mcleancraig/presence-sensor-nrf/enclosure/out/sections/aura_c_center_xz.png

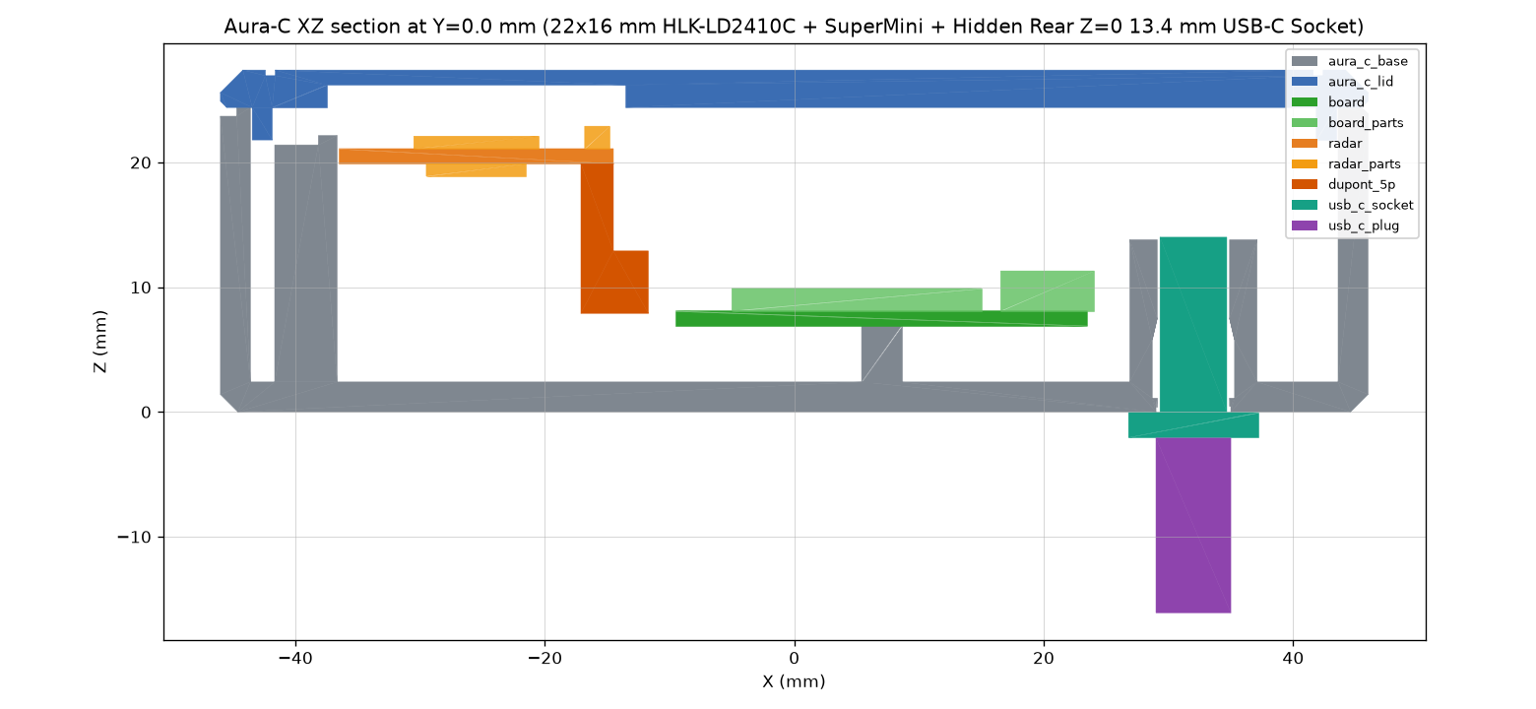
enclosure/out/sections/aura_c_center_xz.png
