mcleancraig/presence-sensor-nrf/enclosure/out/sections/aura_c_front_xy.png

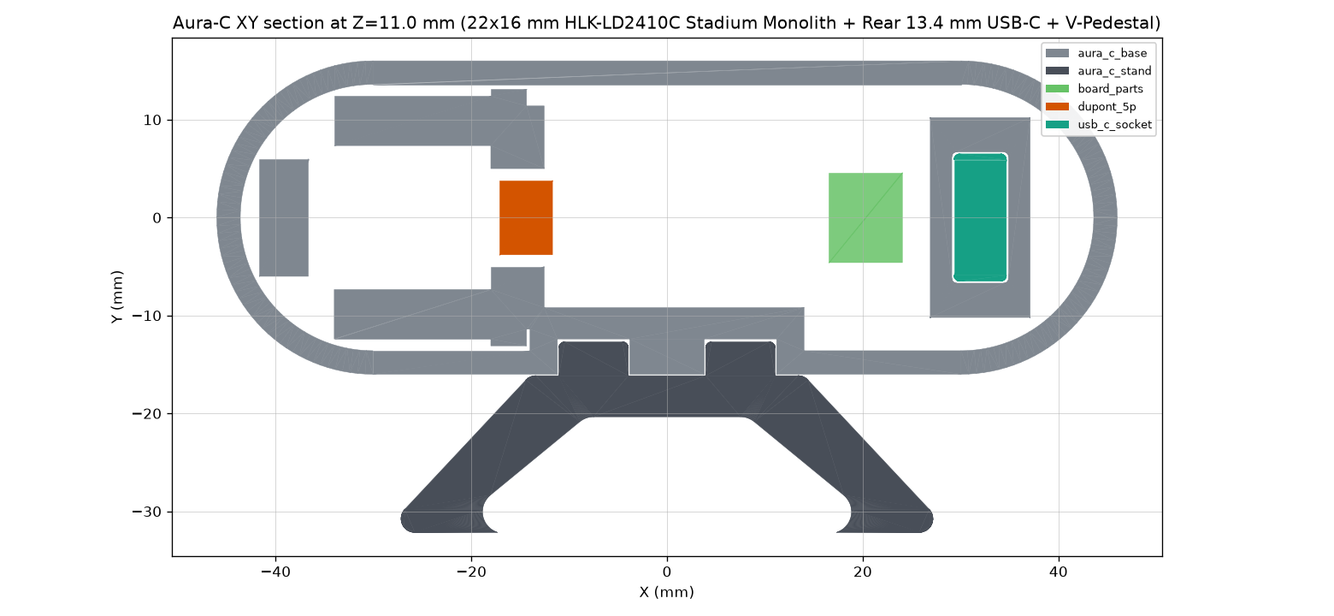
enclosure/out/sections/aura_c_front_xy.png
