mcleancraig/presence-sensor-nrf/enclosure/out/sections/aura_c_stand_yz.png

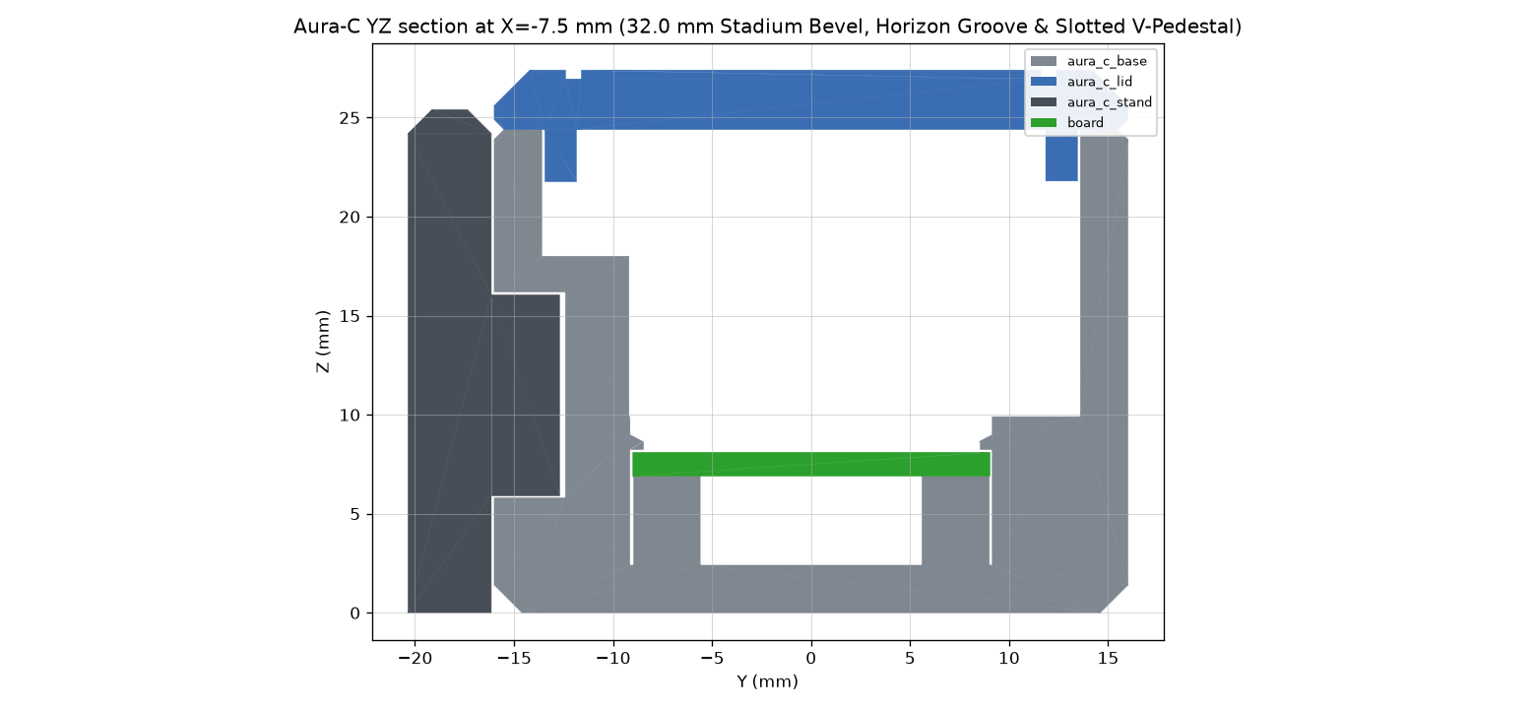
enclosure/out/sections/aura_c_stand_yz.png
