mcleancraig/presence-sensor-nrf/enclosure/out/sections/aura_c_v2_center_xz.png

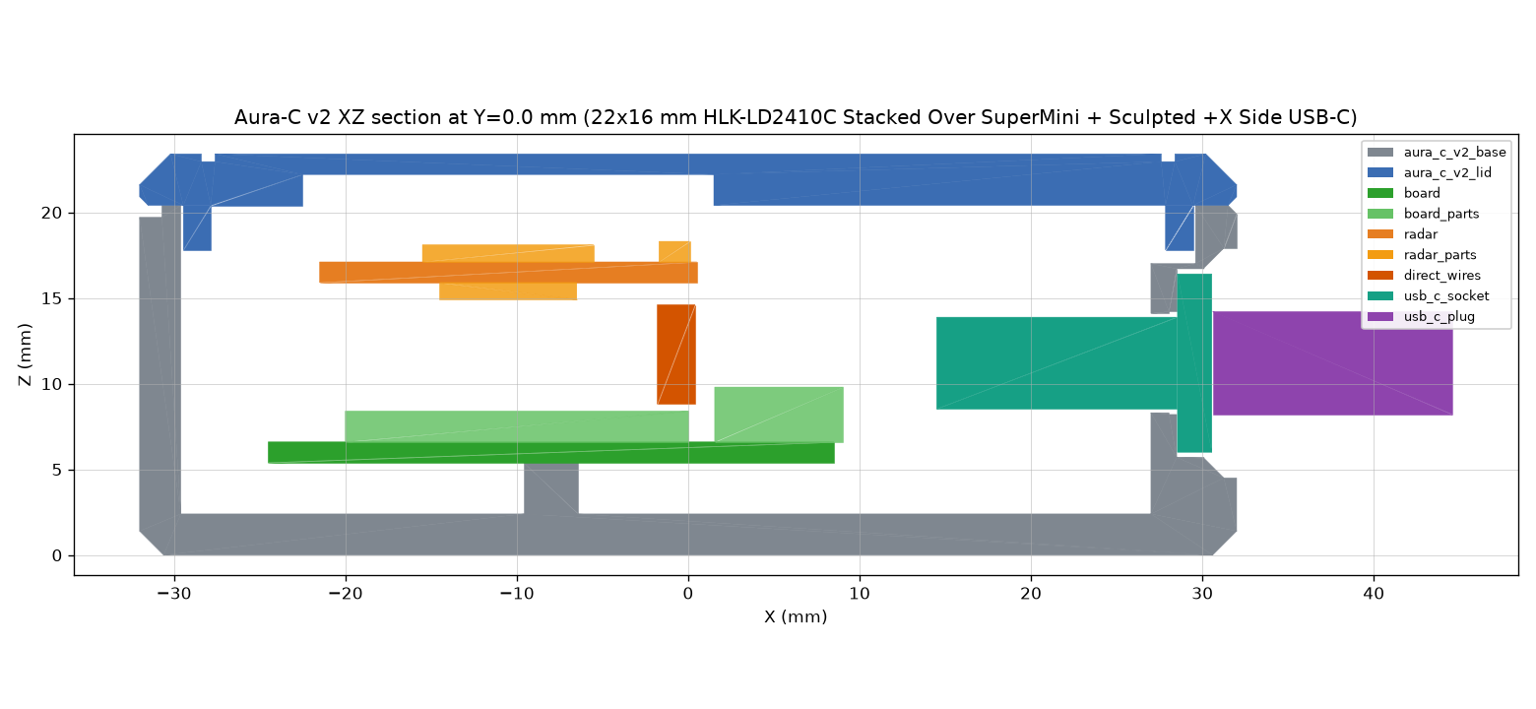
enclosure/out/sections/aura_c_v2_center_xz.png
