mcleancraig/presence-sensor-nrf/enclosure/out/sections/aura_c_v2_stack_yz.png

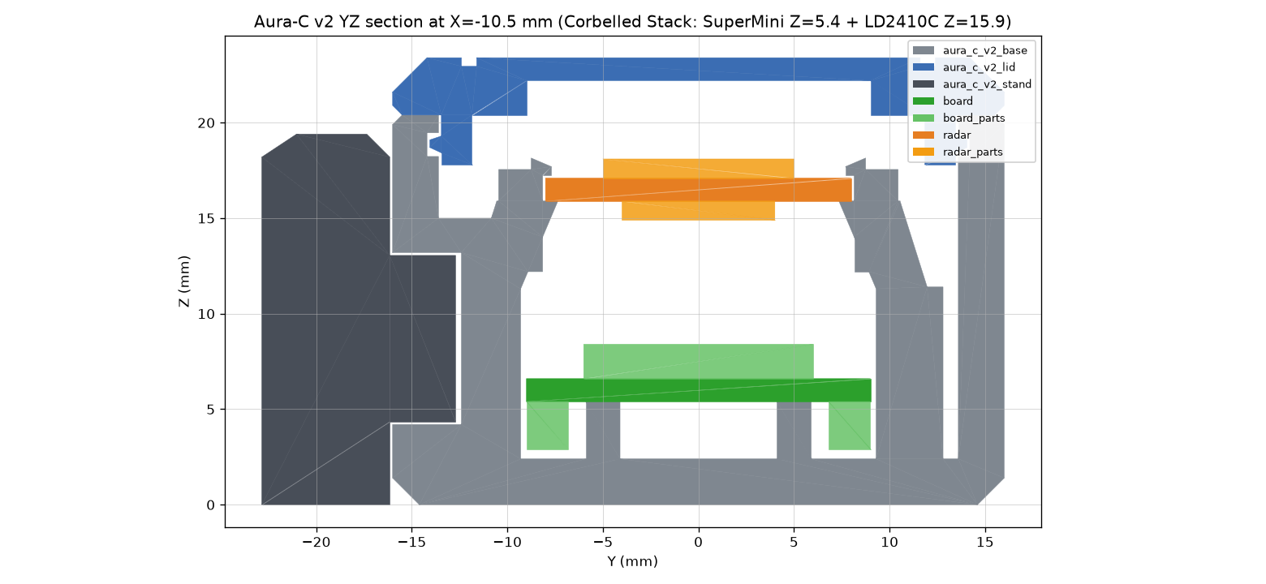
enclosure/out/sections/aura_c_v2_stack_yz.png
