mcleancraig/presence-sensor-nrf/enclosure/out/sections/aura_s_center_xz.png

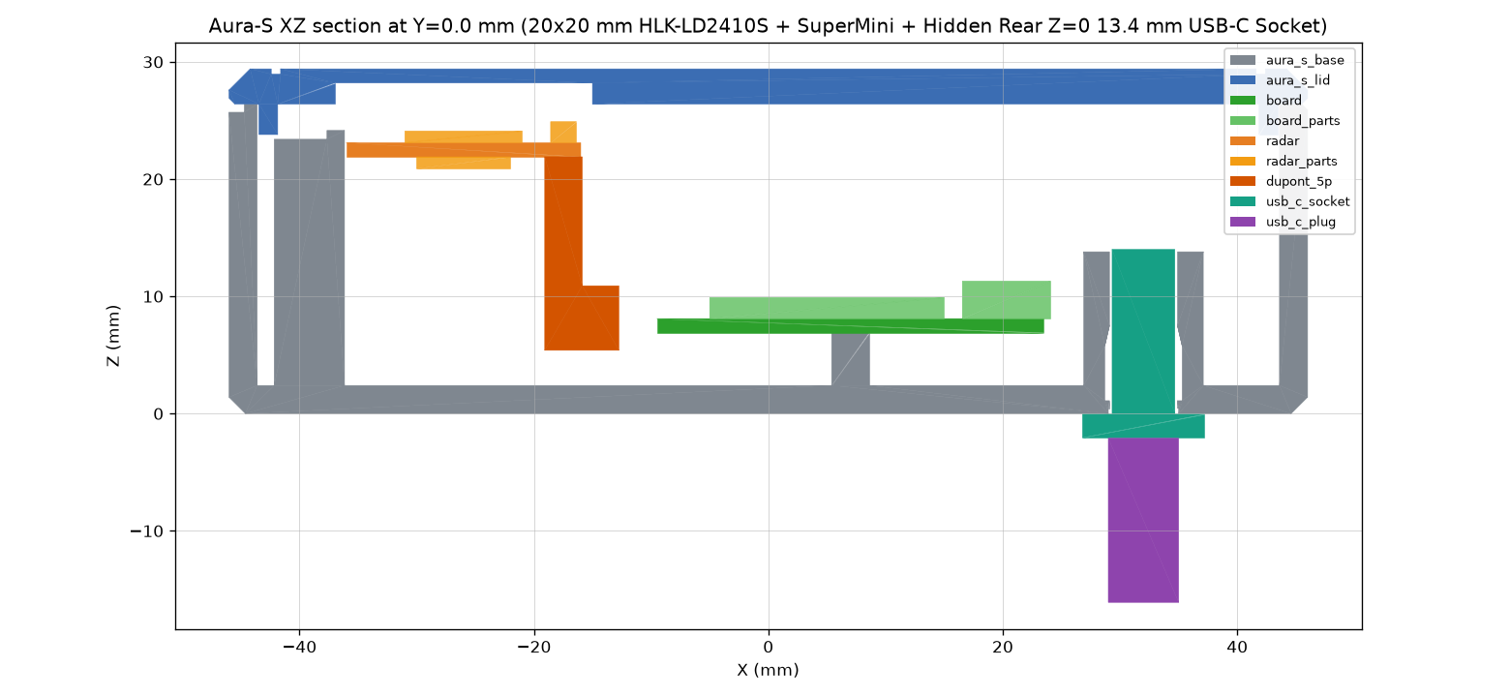
enclosure/out/sections/aura_s_center_xz.png
