mcleancraig/presence-sensor-nrf/enclosure/out/sections/aura_v2_front_xy.png

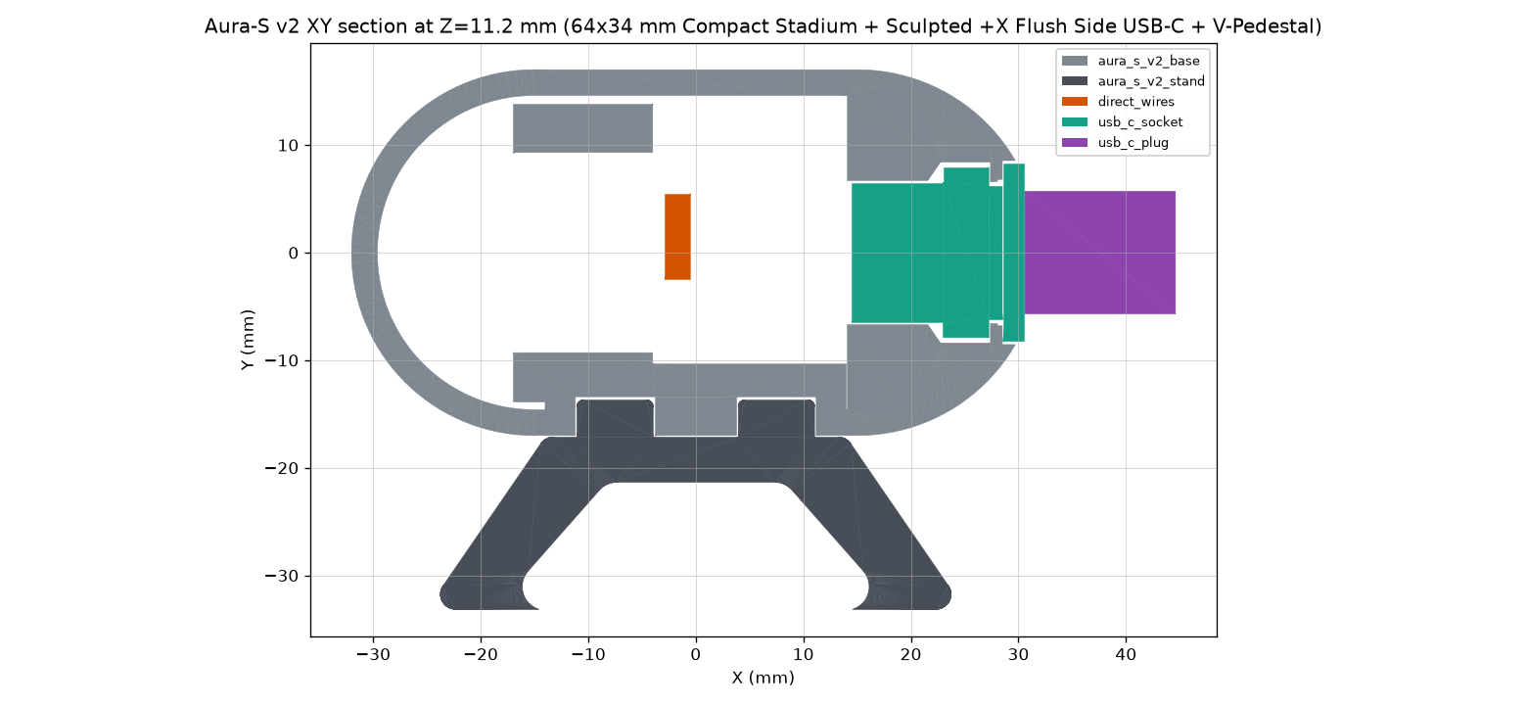
enclosure/out/sections/aura_v2_front_xy.png
