mcleancraig/presence-sensor-nrf/enclosure/out/sections/corner_bracket_x.png

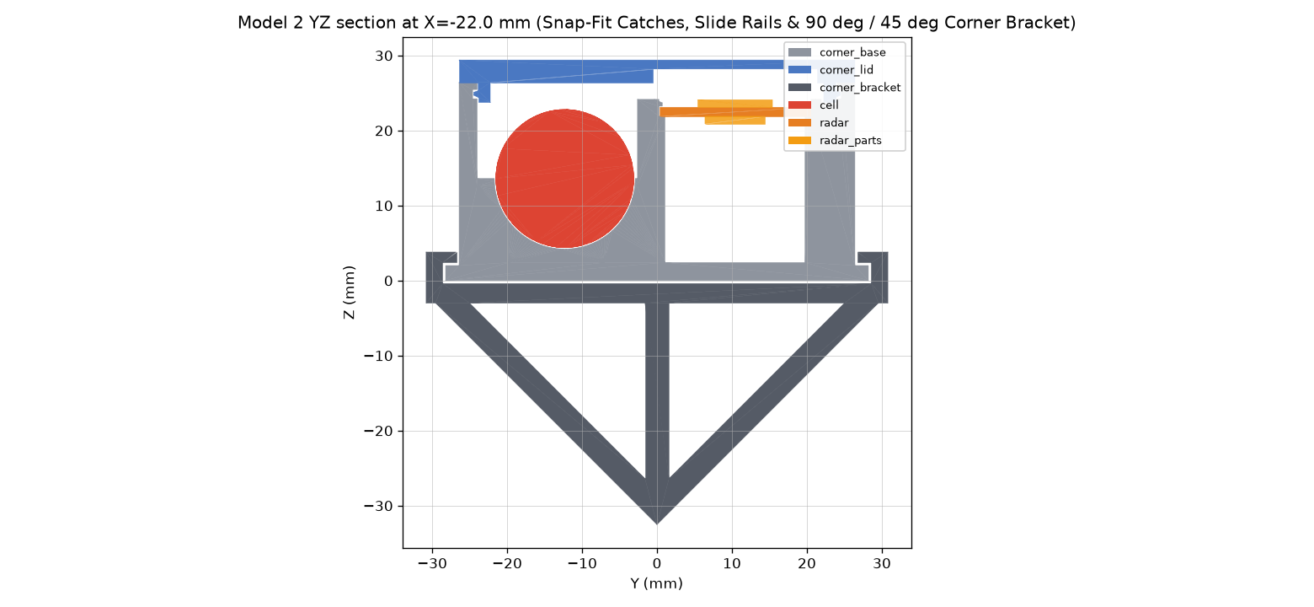
enclosure/out/sections/corner_bracket_x.png
