mcleancraig/presence-sensor-nrf/enclosure/out/sections/corner_snap_y.png

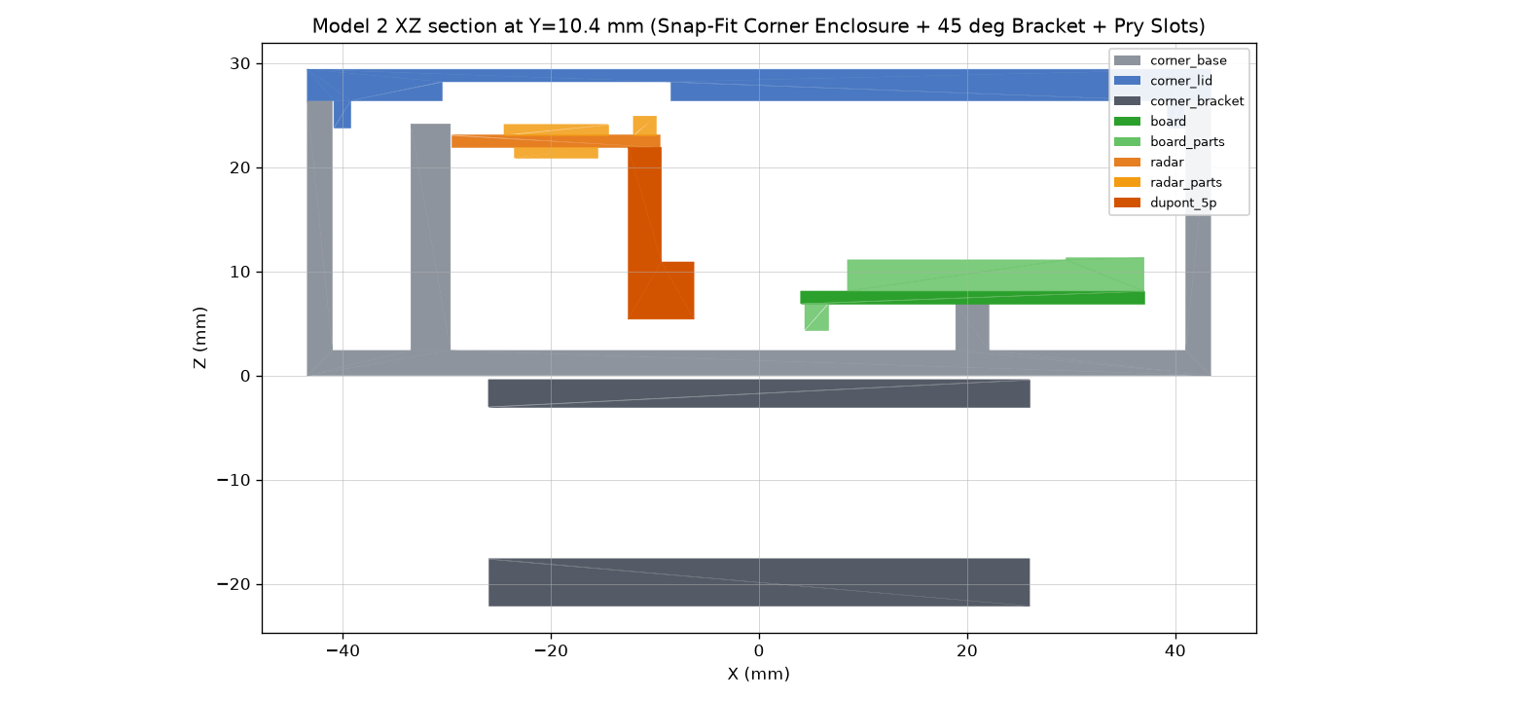
enclosure/out/sections/corner_snap_y.png
