mcleancraig/presence-sensor-nrf/enclosure/out/sections/ld2410c_radar_x.png

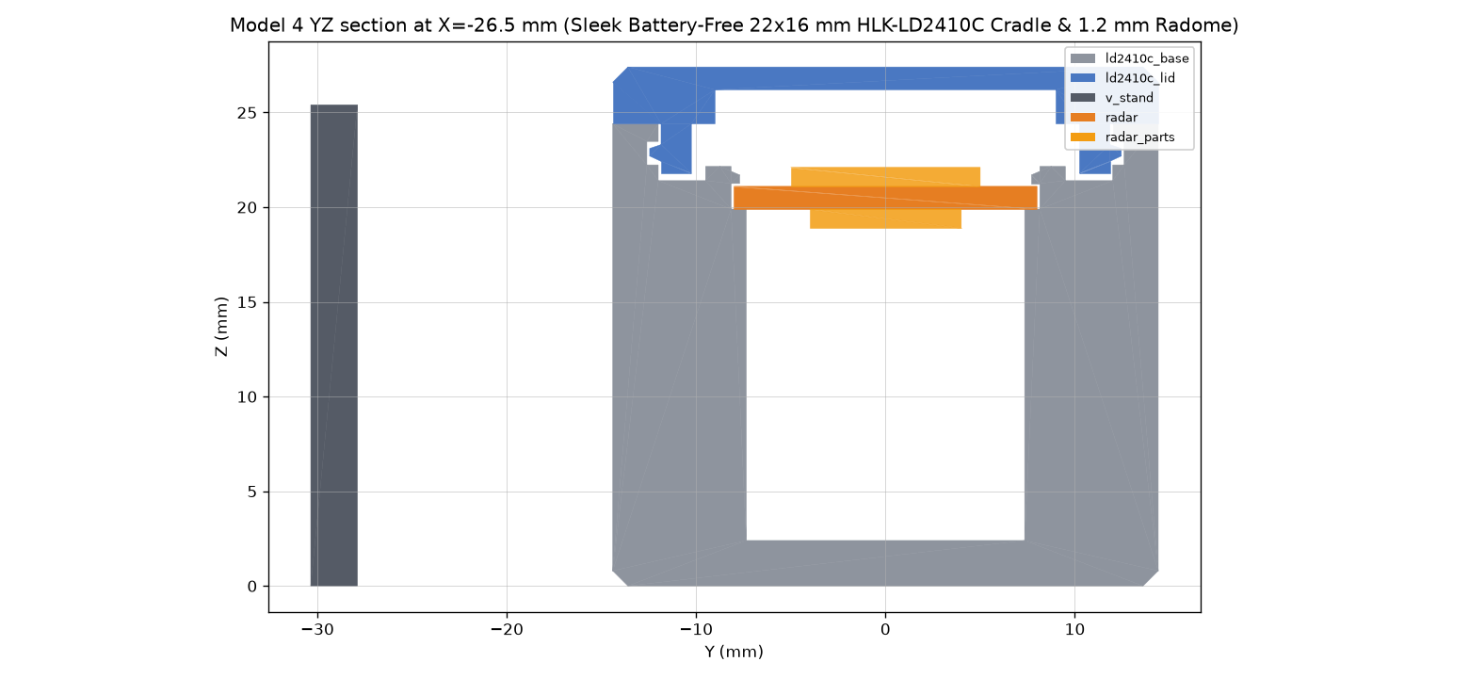
enclosure/out/sections/ld2410c_radar_x.png
