mcleancraig/presence-sensor-nrf/enclosure/out/sections/ld2410c_usbc_y.png

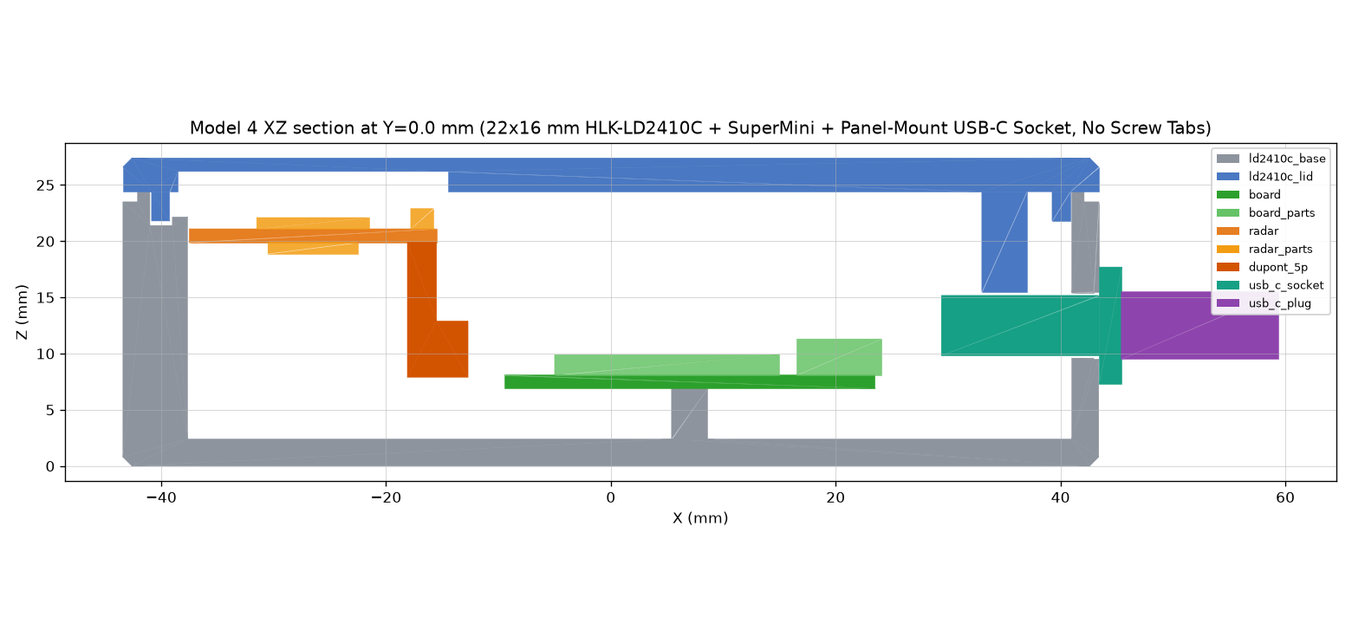
enclosure/out/sections/ld2410c_usbc_y.png
