mcleancraig/presence-sensor-nrf/enclosure/out/sections/ld2410c_z_radar.png

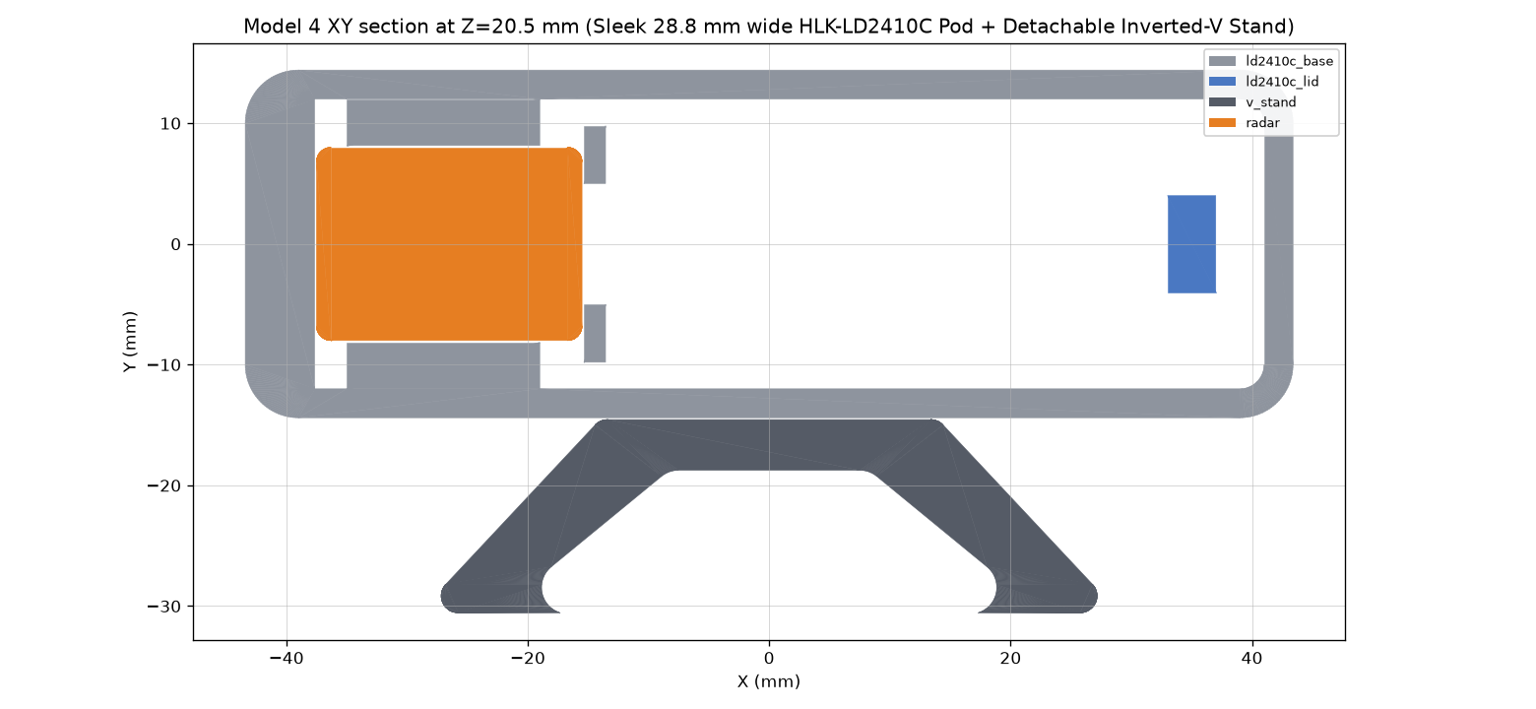
enclosure/out/sections/ld2410c_z_radar.png
