mcleancraig/presence-sensor-nrf/enclosure/out/sections/ld2410s_usb_usbc_y.png

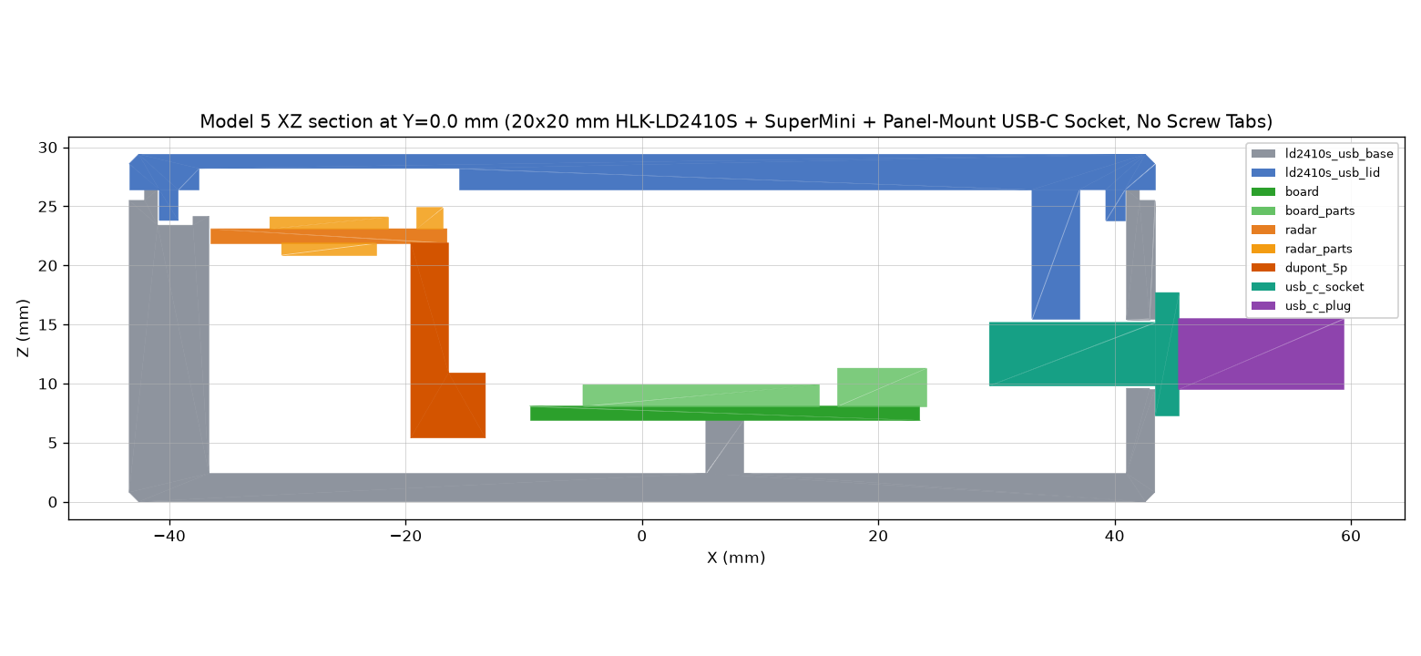
enclosure/out/sections/ld2410s_usb_usbc_y.png
