mcleancraig/presence-sensor-nrf/enclosure/out/sections/ld2410s_usb_z_radar.png

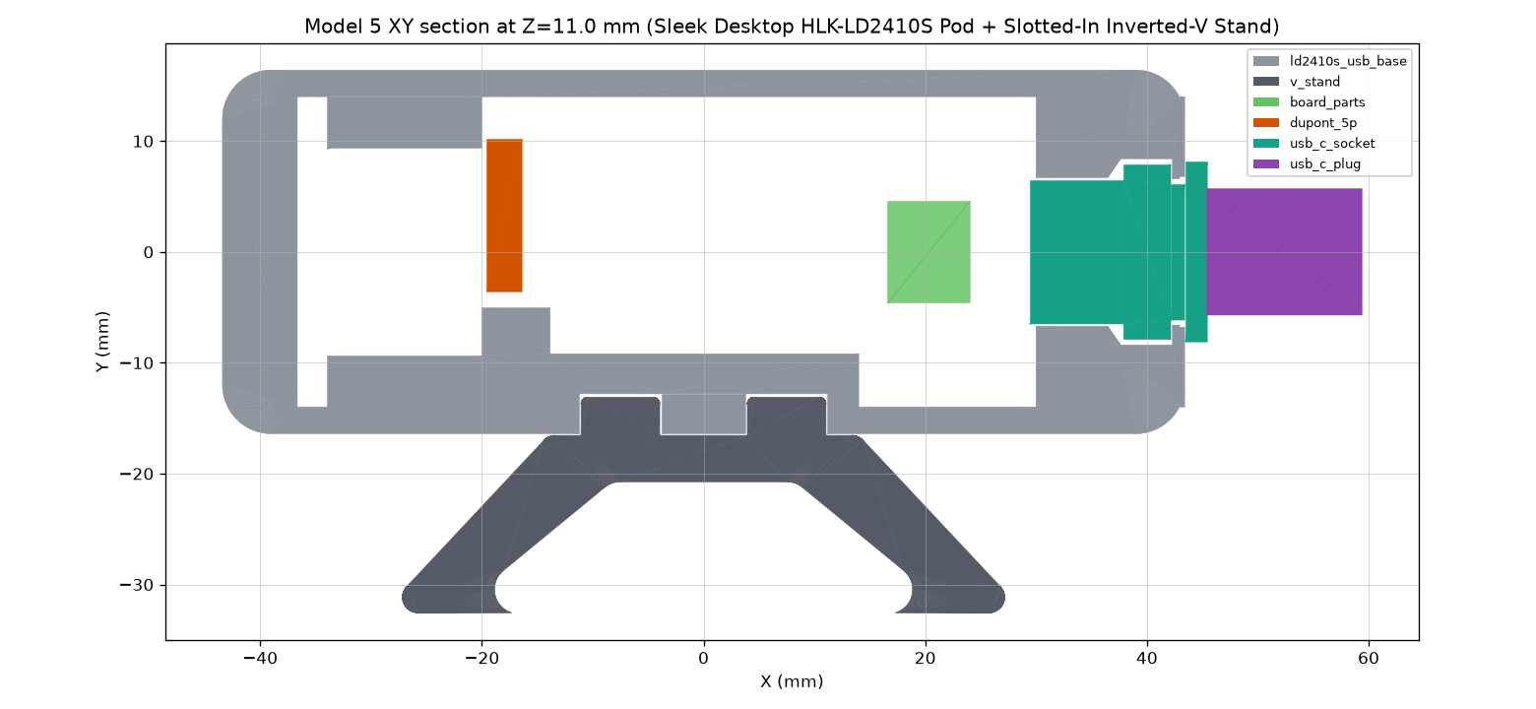
enclosure/out/sections/ld2410s_usb_z_radar.png
