mcleancraig/presence-sensor-nrf/enclosure/out/sections/vanity_standing_x.png

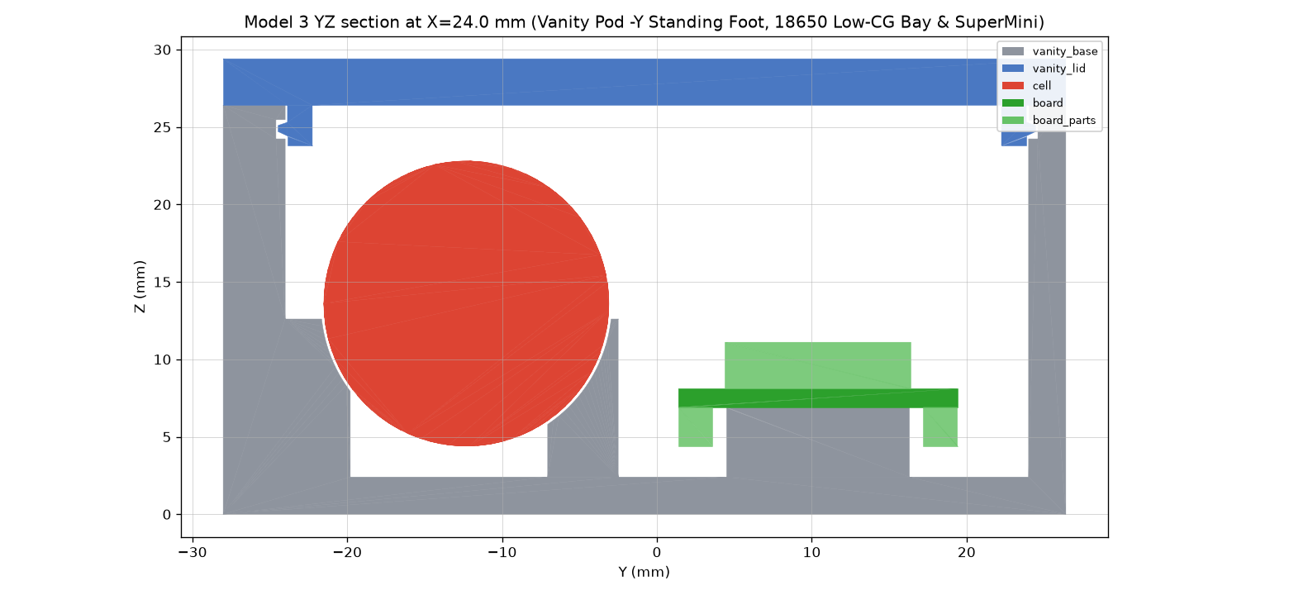
enclosure/out/sections/vanity_standing_x.png
