mcleancraig/presence-sensor-nrf/enclosure/out/sections/vanity_usbc_y.png

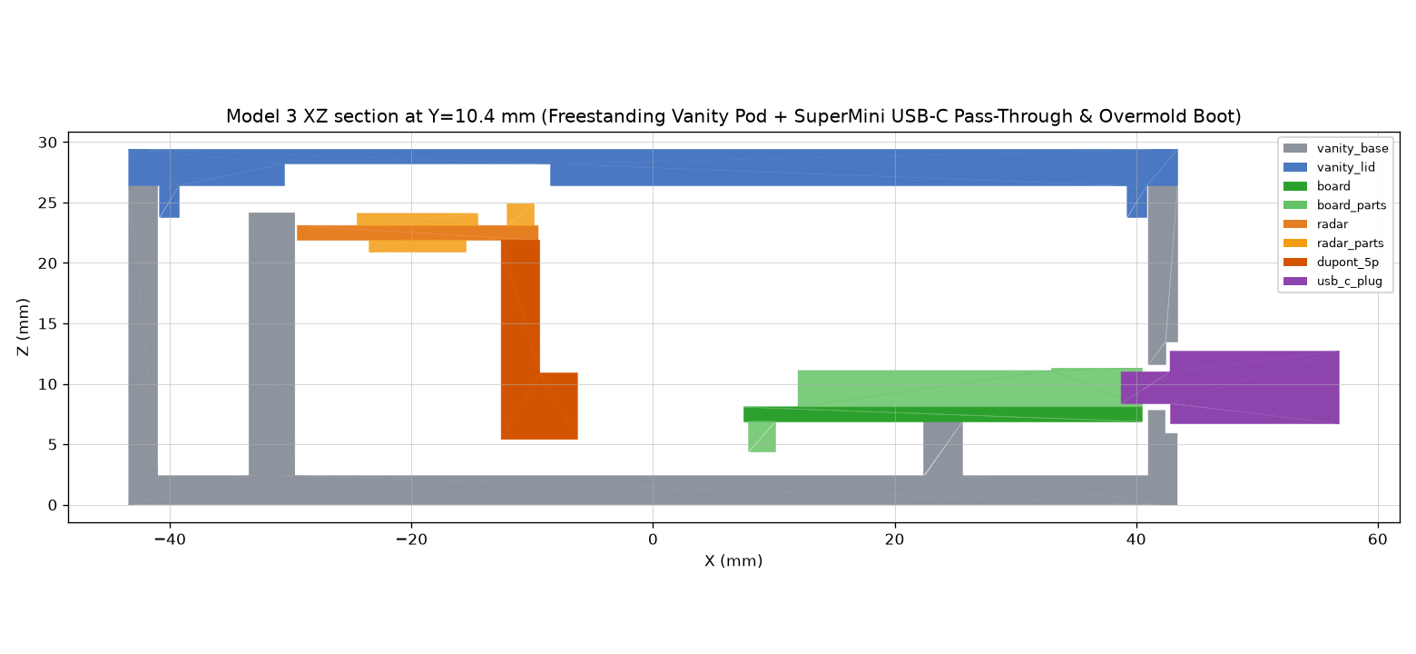
enclosure/out/sections/vanity_usbc_y.png
