mcleancraig/presence-sensor-nrf/enclosure/out/sections/x_board.png

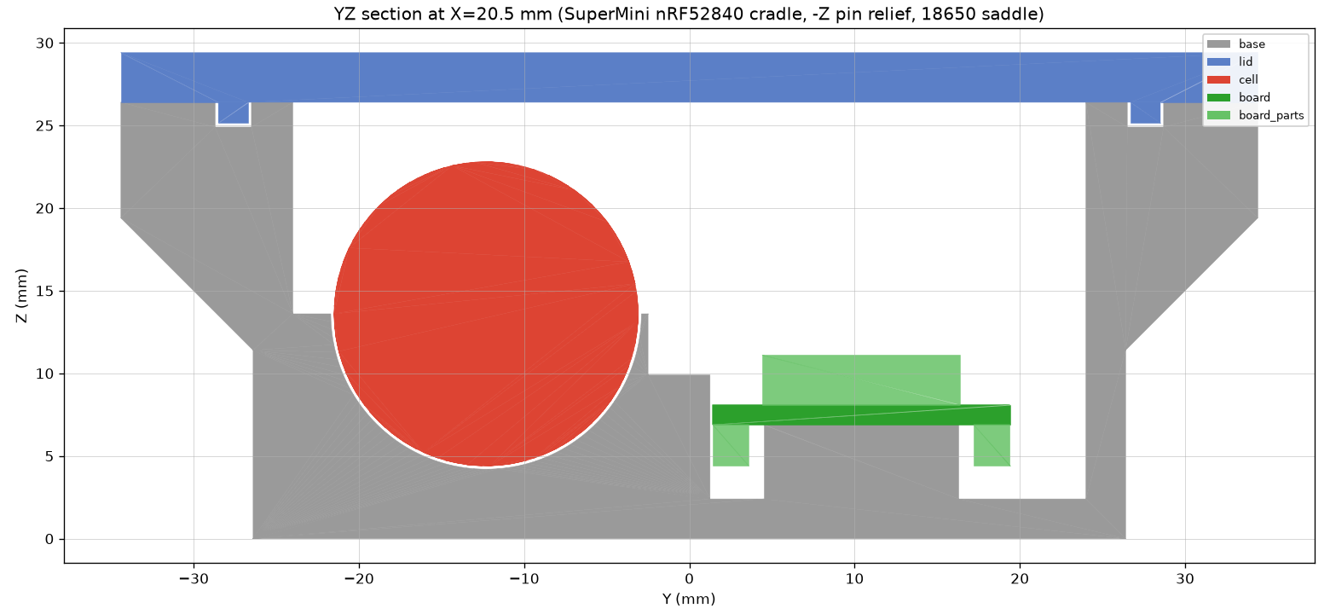
enclosure/out/sections/x_board.png
