mcleancraig/presence-sensor-nrf/enclosure/out/sections/x_center.png

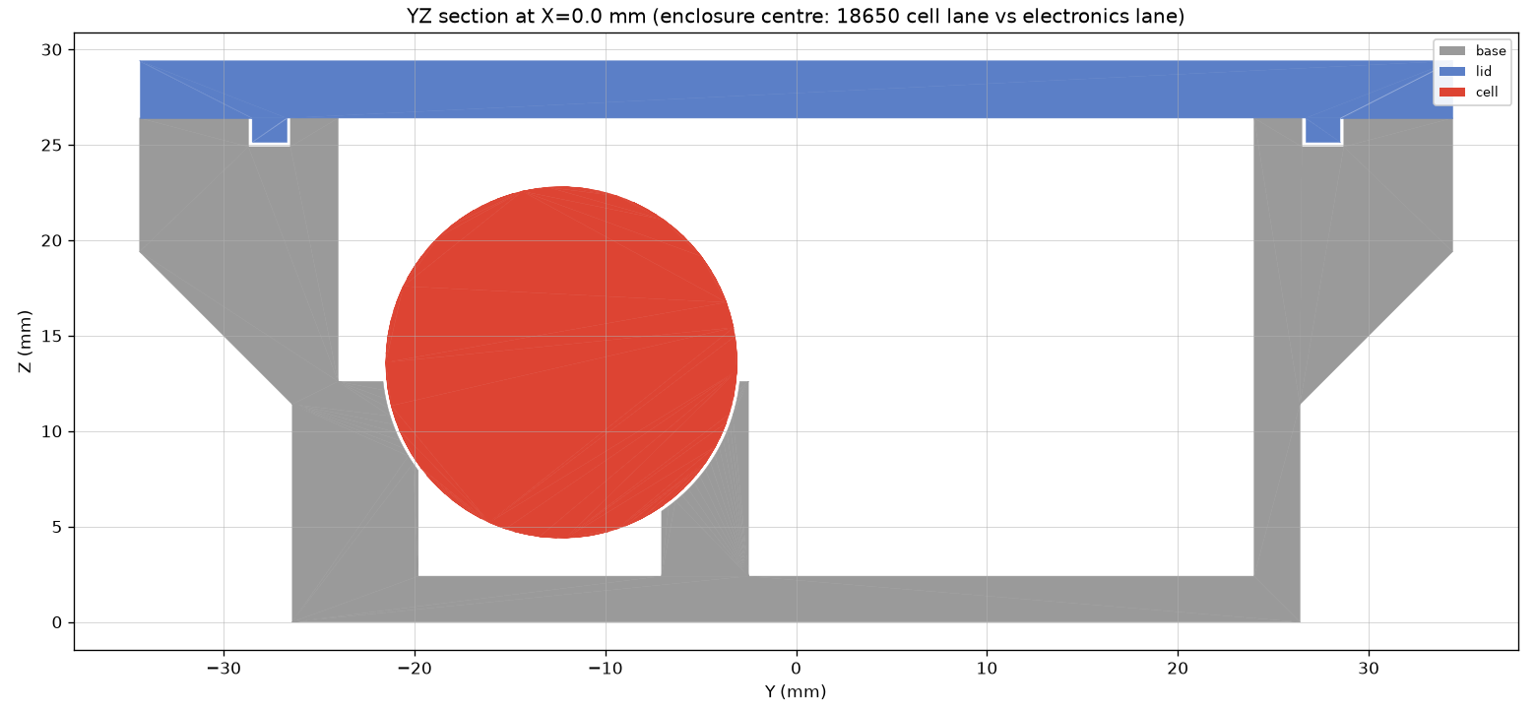
enclosure/out/sections/x_center.png
