mcleancraig/presence-sensor-nrf/enclosure/out/sections/x_radar.png

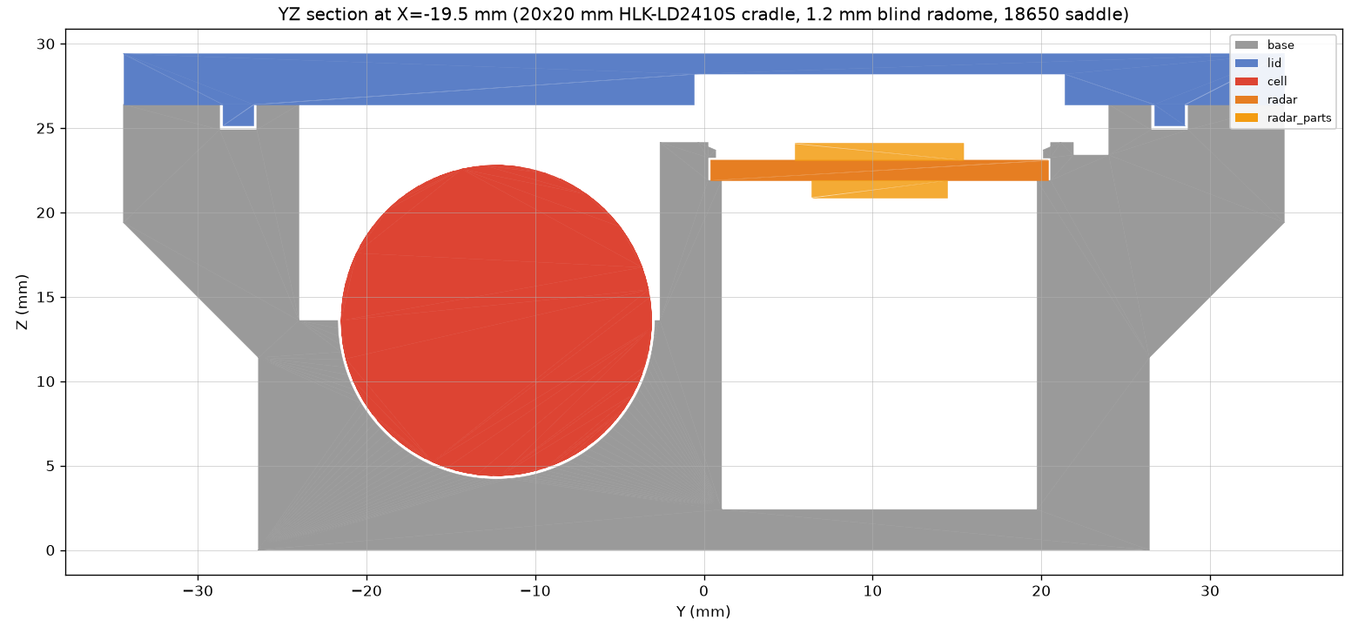
enclosure/out/sections/x_radar.png
