mcleancraig/presence-sensor-nrf/enclosure/out/sections/x_slot_neg.png

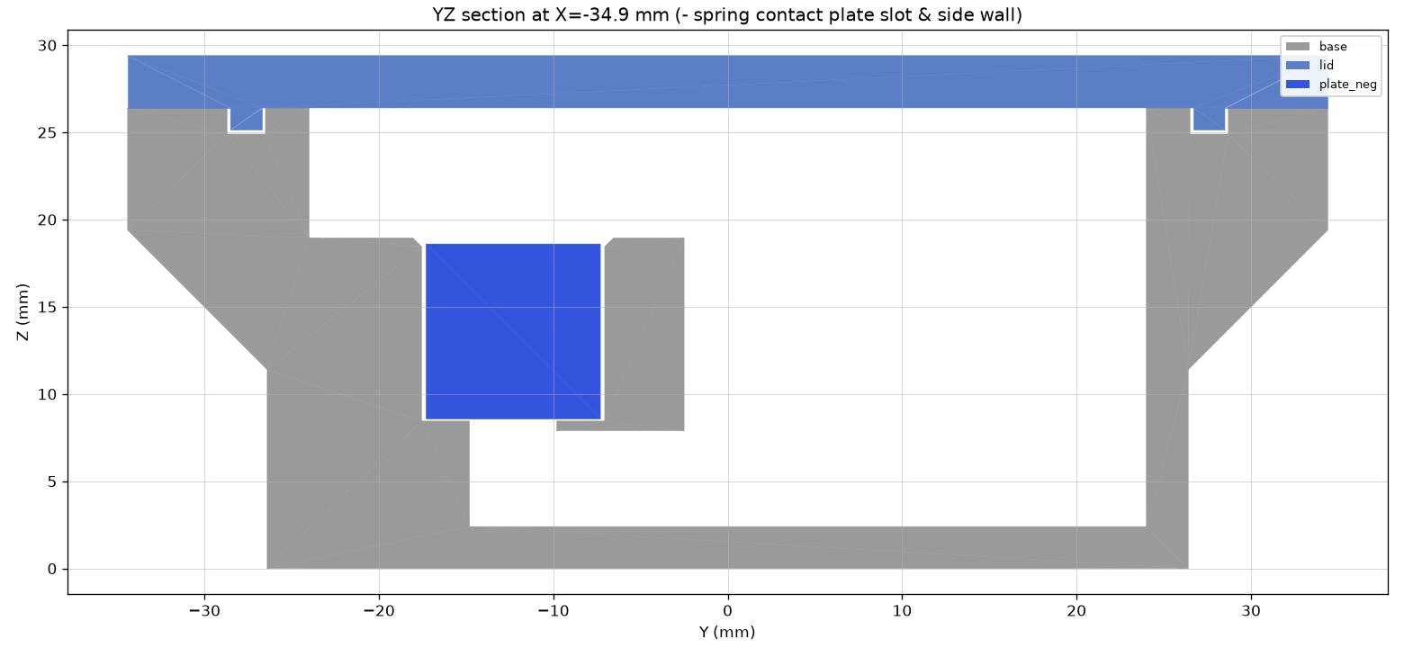
enclosure/out/sections/x_slot_neg.png
