mcleancraig/presence-sensor-nrf/enclosure/out/sections/x_slot_pos.png

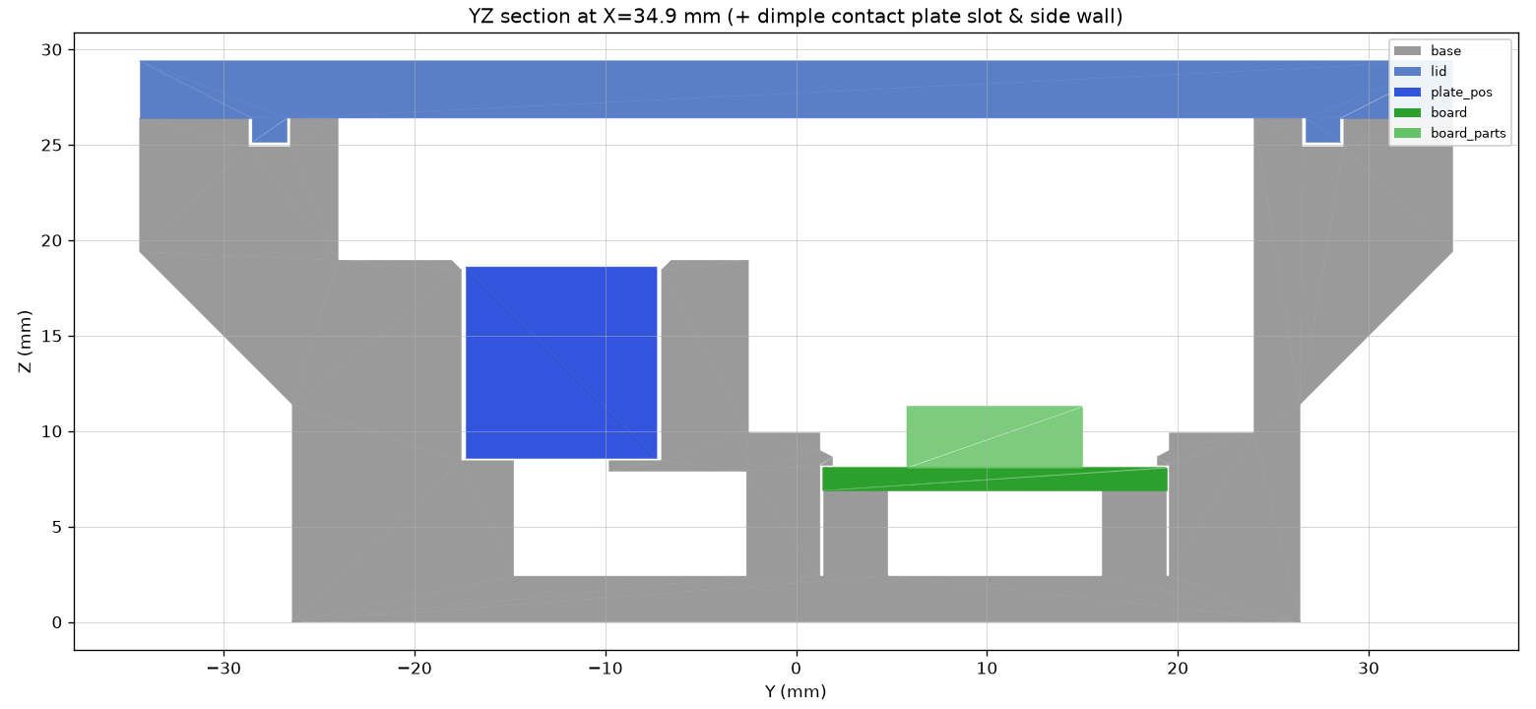
enclosure/out/sections/x_slot_pos.png
