mcleancraig/presence-sensor-nrf/enclosure/out/sections/y_battery.png

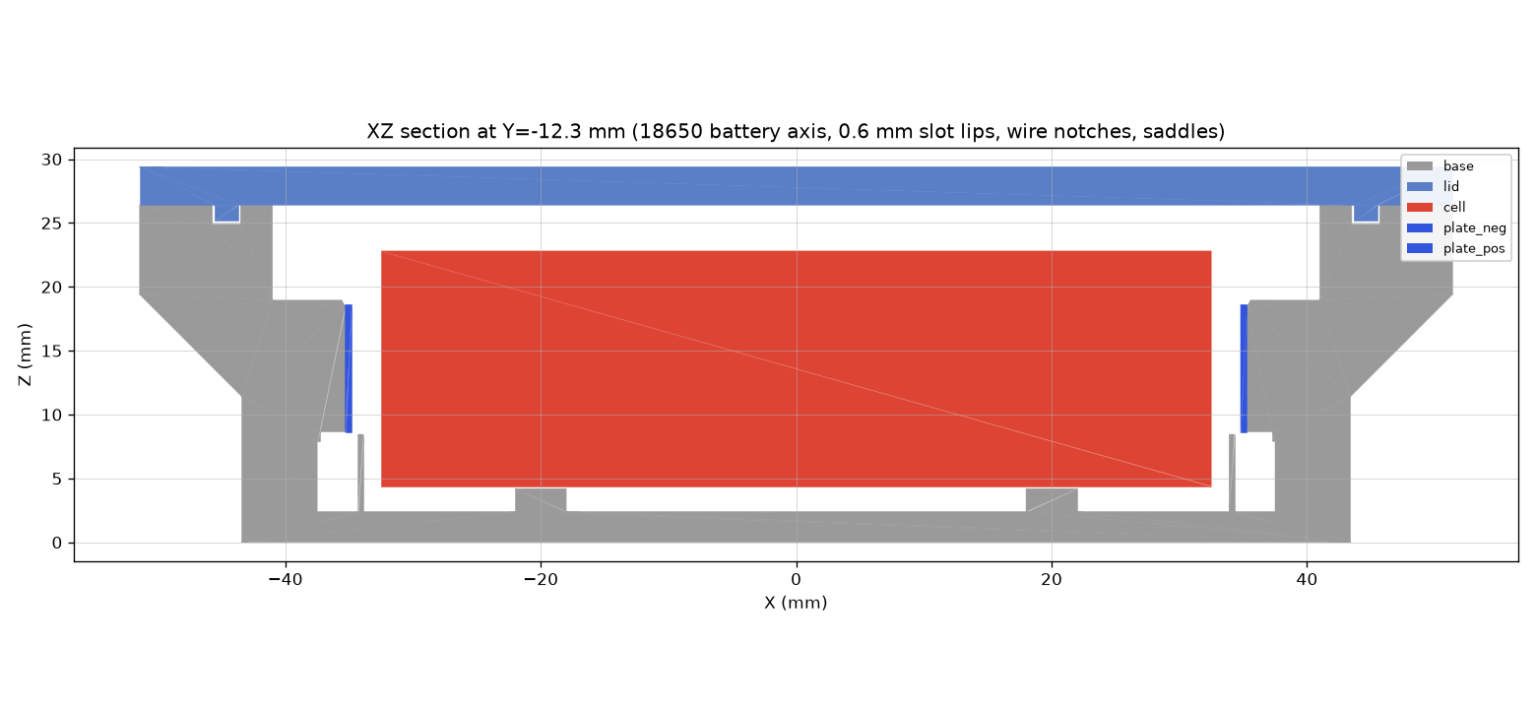
enclosure/out/sections/y_battery.png
