mcleancraig/presence-sensor-nrf/enclosure/out/sections/y_electronics.png

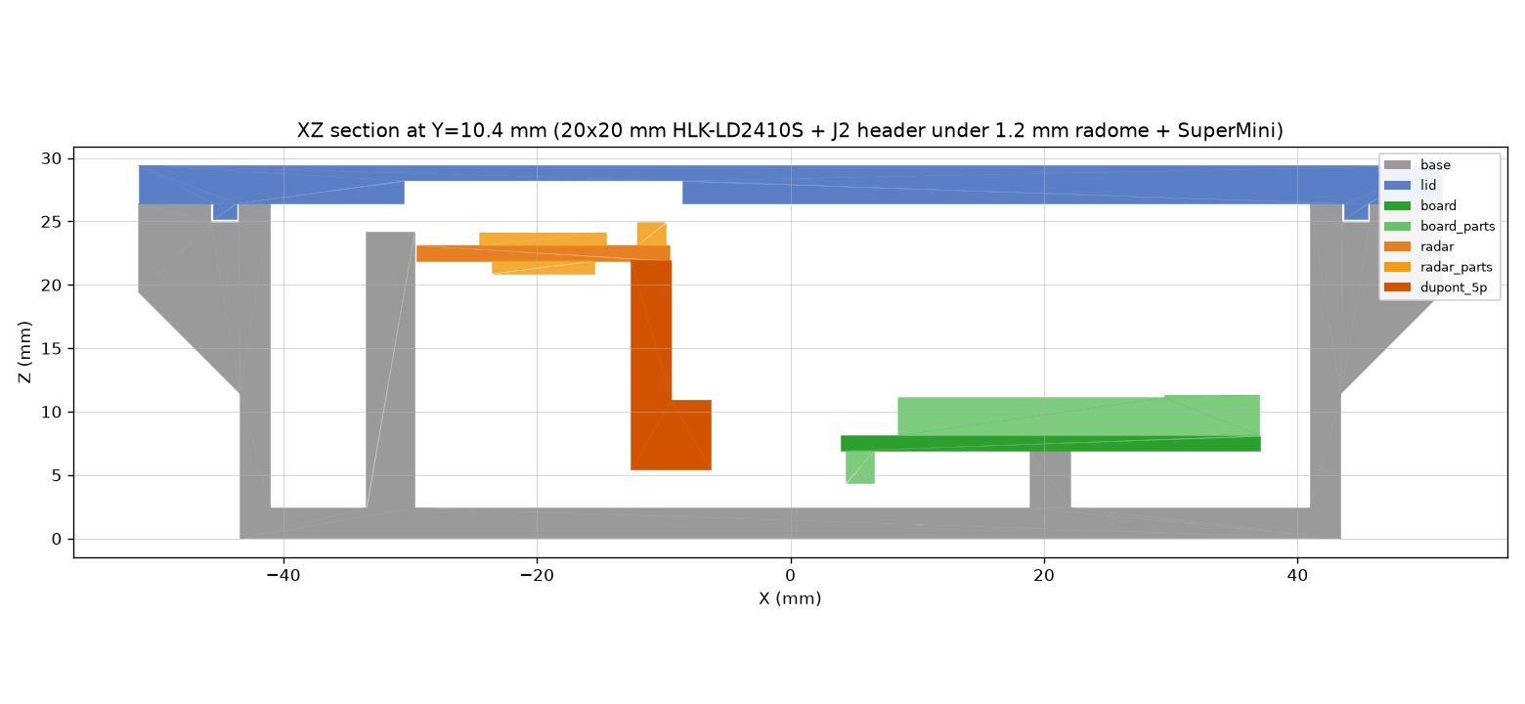
enclosure/out/sections/y_electronics.png
