mcleancraig/presence-sensor-nrf/enclosure/out/sections/z_board.png

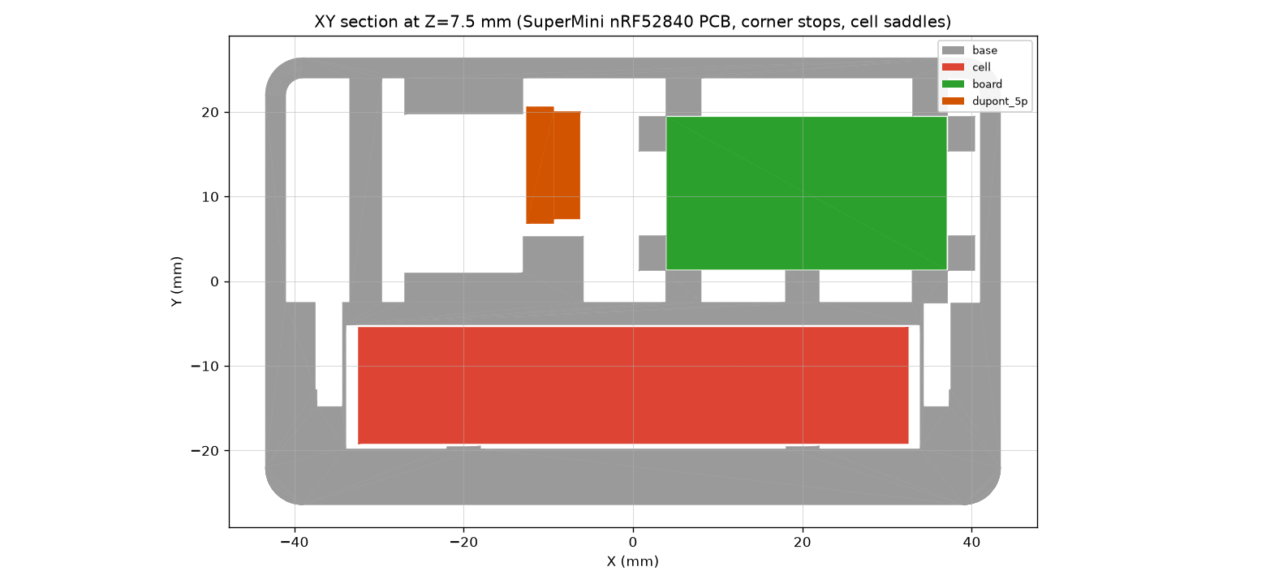
enclosure/out/sections/z_board.png
