mcleancraig/presence-sensor-nrf/enclosure/out/sections/z_flange.png

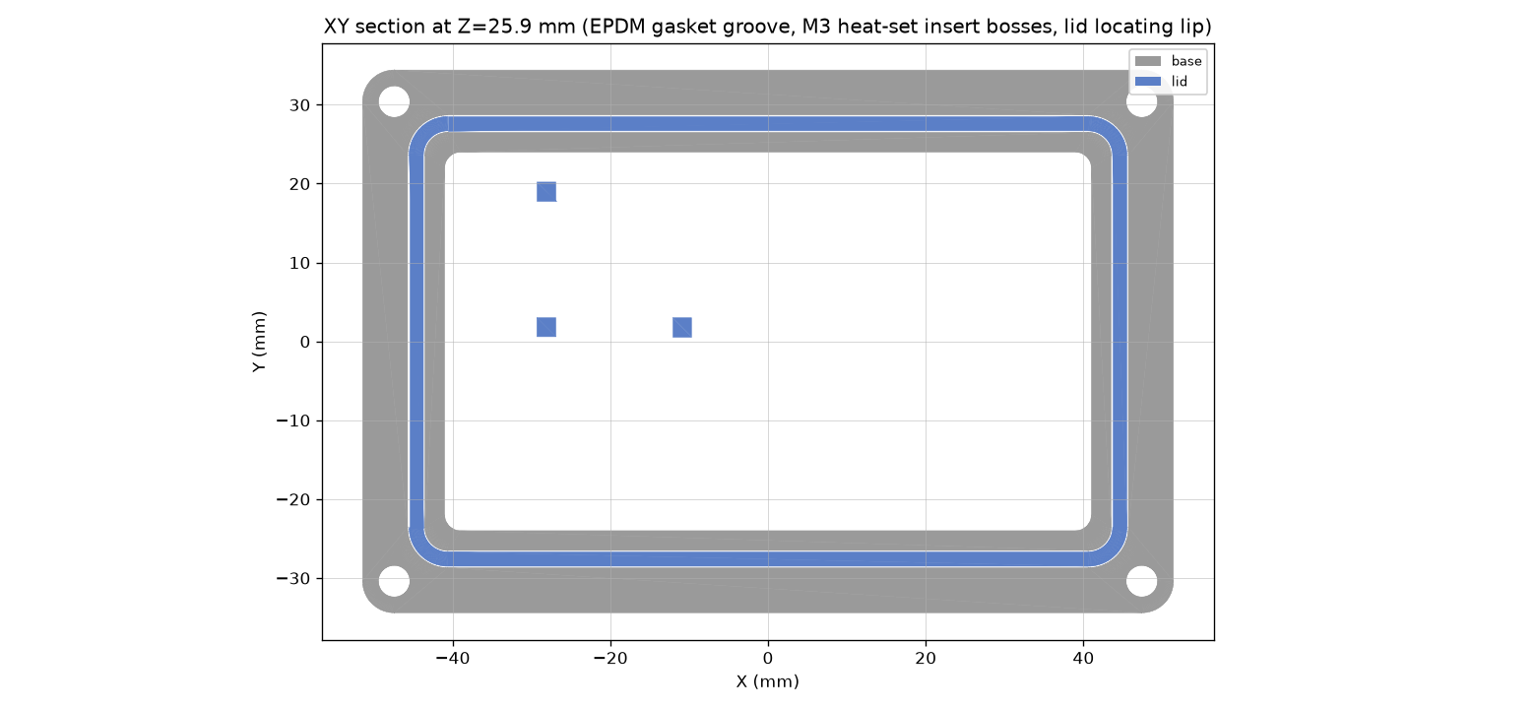
enclosure/out/sections/z_flange.png
