mcleancraig/presence-sensor-nrf/enclosure/out/sections/z_mid_cell.png

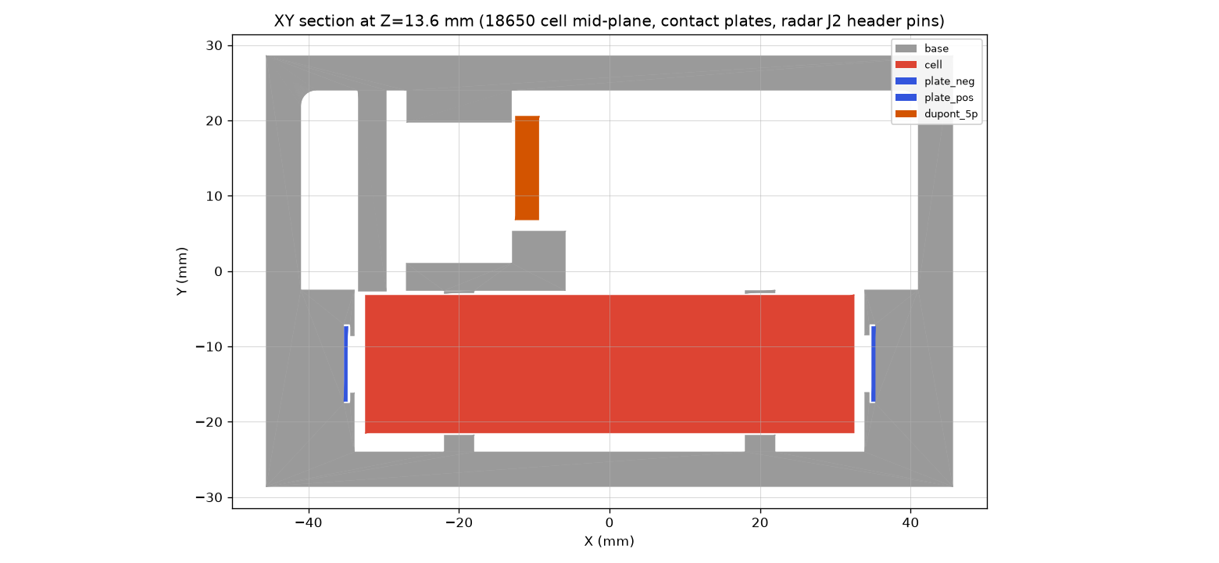
enclosure/out/sections/z_mid_cell.png
