mcleancraig/presence-sensor-nrf/enclosure/out/sections/z_radar.png

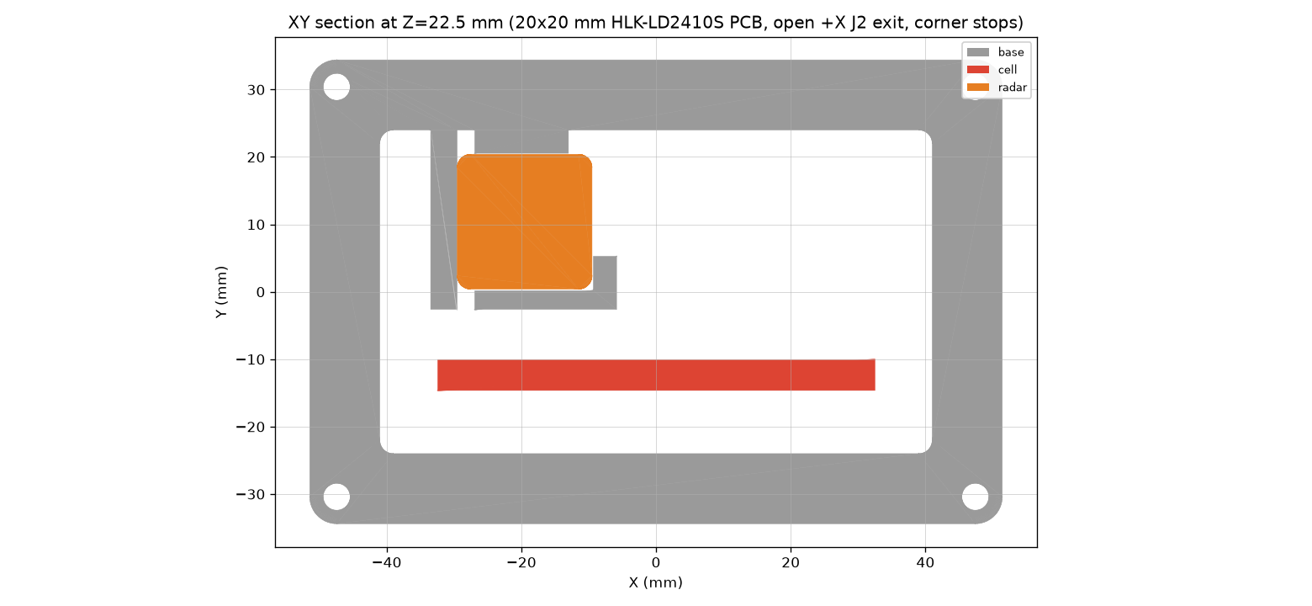
enclosure/out/sections/z_radar.png
