mcleancraig/presence-sensor-nrf/enclosure/out/sections/z_radome.png

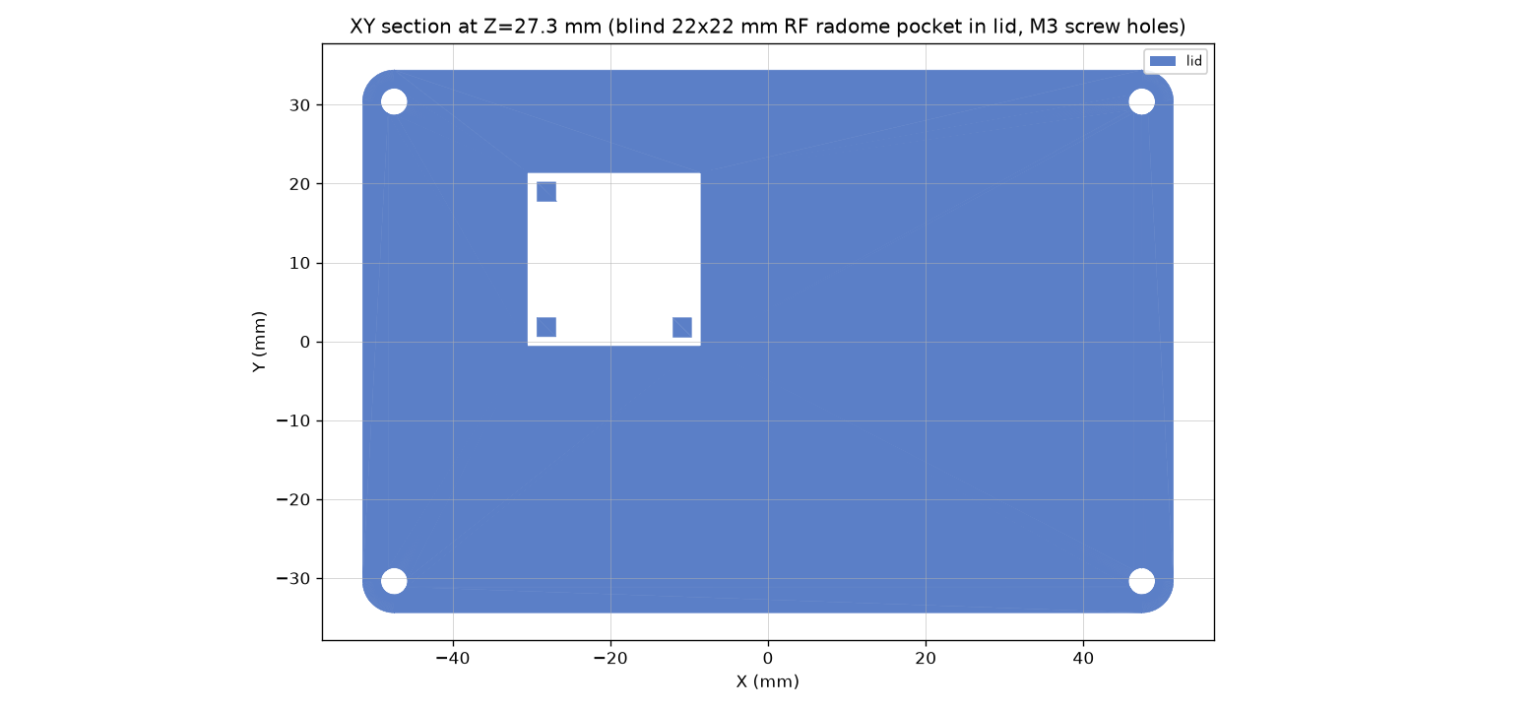
enclosure/out/sections/z_radome.png
