mcleancraig/presence-sensor-nrf/enclosure/out/ld2410c_assembly.step

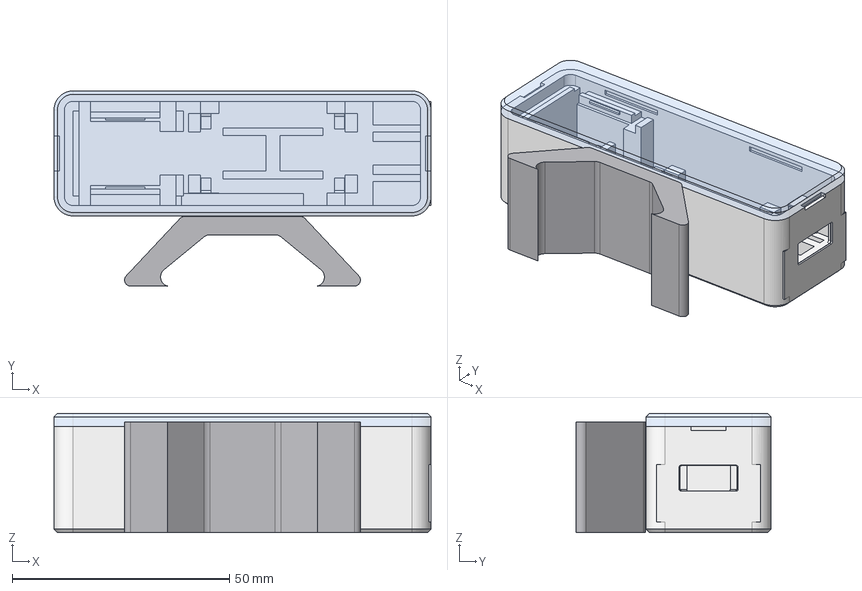
[picture p29: CAD file, 2026-11-10]
enclosure/out/ld2410c_assembly.step
86.8 x 45.0 x 27.4 mm
ld2410c_base
ld2410c_lid
v_stand
