mcleancraig/presence-sensor-nrf/enclosure/out/aura_c_v2_assembly.step

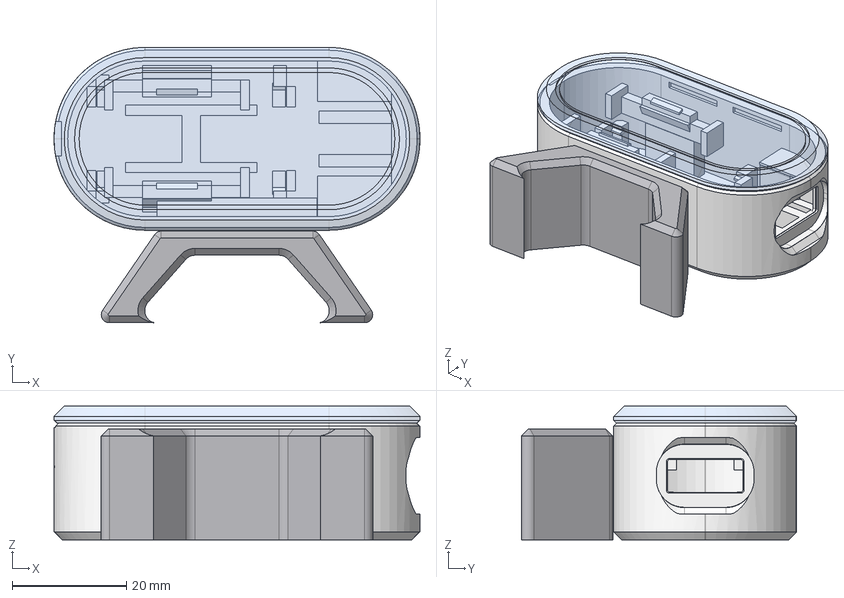
[picture p30: CAD file, 2026-11-10]
enclosure/out/aura_c_v2_assembly.step
64.0 x 48.1 x 23.4 mm
aura_c_v2_base
aura_c_v2_lid
v_stand
