mcleancraig/presence-sensor-nrf/enclosure/out/aura_s_assembly.step

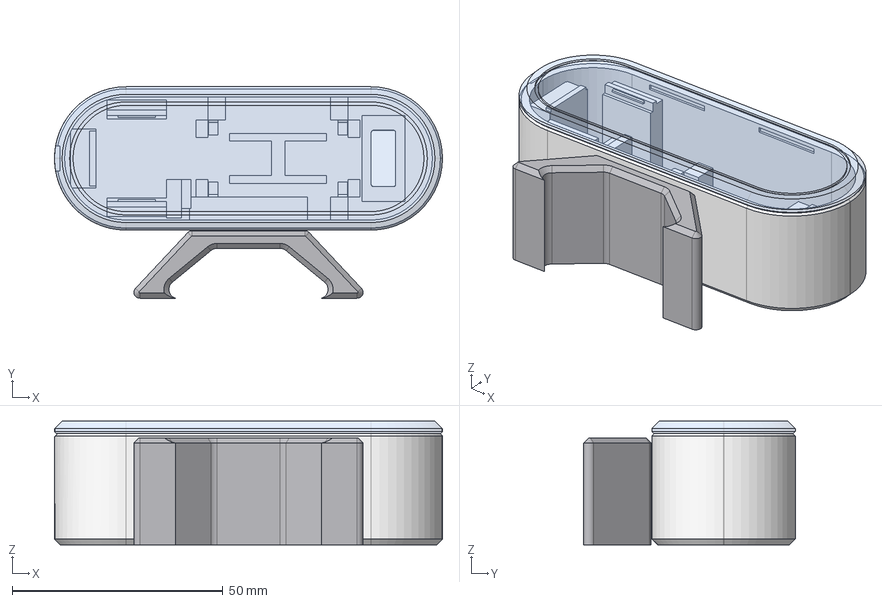
[picture p31: CAD file, 2026-11-10]
enclosure/out/aura_s_assembly.step
92.0 x 50.1 x 29.4 mm
aura_s_base
aura_s_lid
v_stand
