mcleancraig/presence-sensor-nrf/enclosure/out/aura_s_v2_assembly.step

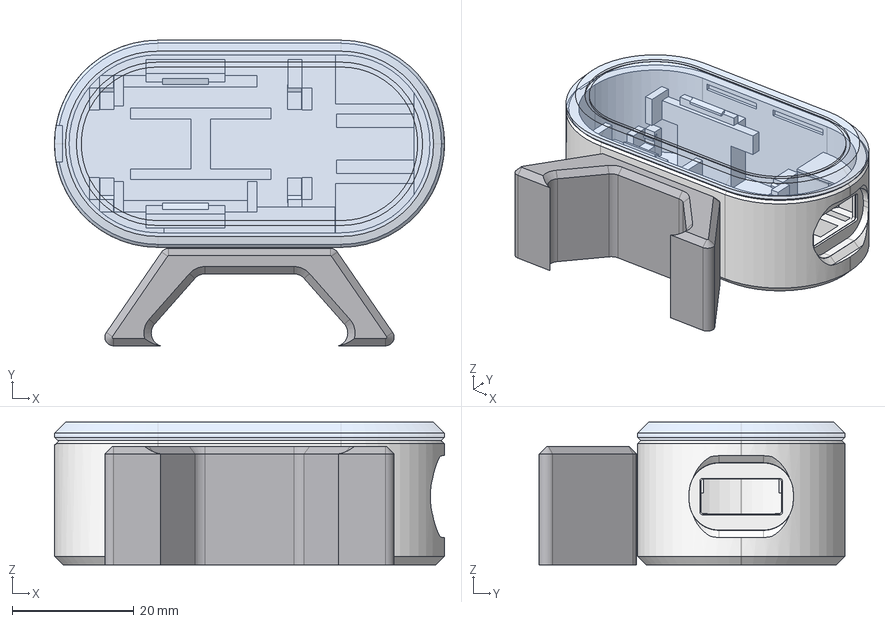
[picture p32: CAD file, 2026-11-10]
enclosure/out/aura_s_v2_assembly.step
64.0 x 50.1 x 23.4 mm
aura_s_v2_base
aura_s_v2_lid
v_stand
