mcleancraig/presence-sensor-nrf/enclosure/out/corner_assembly.step

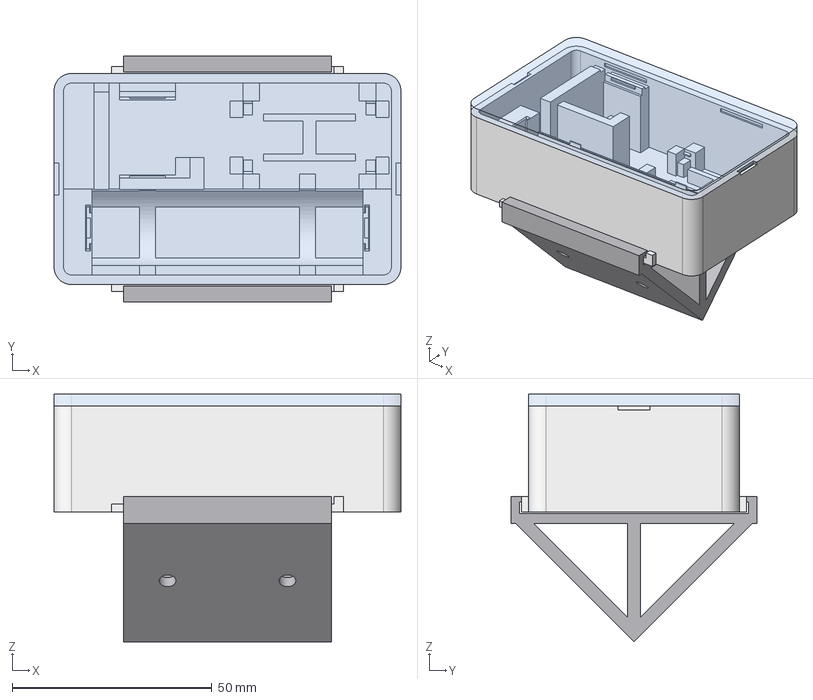
[picture p33: CAD file, 2026-11-10]
enclosure/out/corner_assembly.step
86.8 x 61.6 x 61.9 mm
corner_base
corner_lid
corner_bracket
