mcleancraig/presence-sensor-nrf/enclosure/out/ld2410s_usb_assembly.step

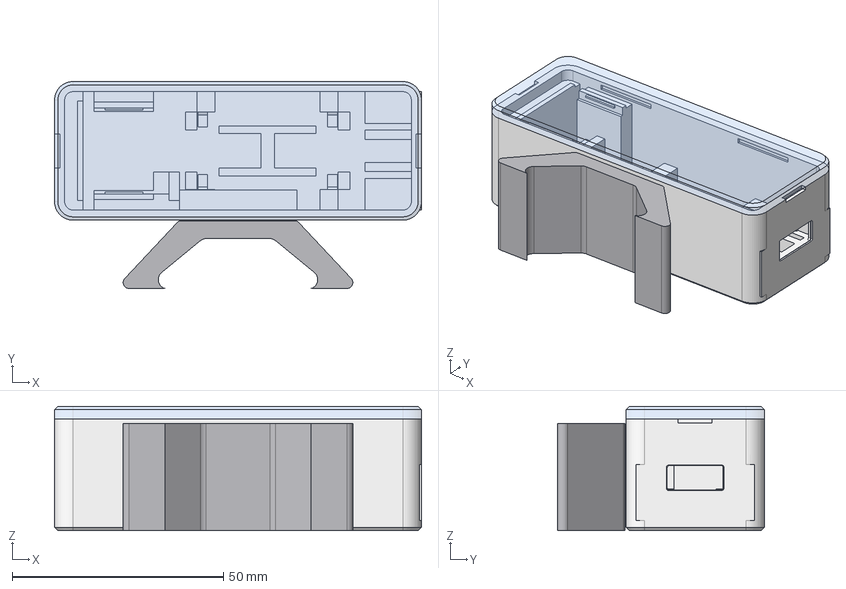
[picture p34: CAD file, 2026-11-10]
enclosure/out/ld2410s_usb_assembly.step
86.8 x 48.9 x 29.4 mm
ld2410s_usb_base
ld2410s_usb_lid
v_stand
