mcleancraig/presence-sensor-nrf/enclosure/out/vanity_assembly.step

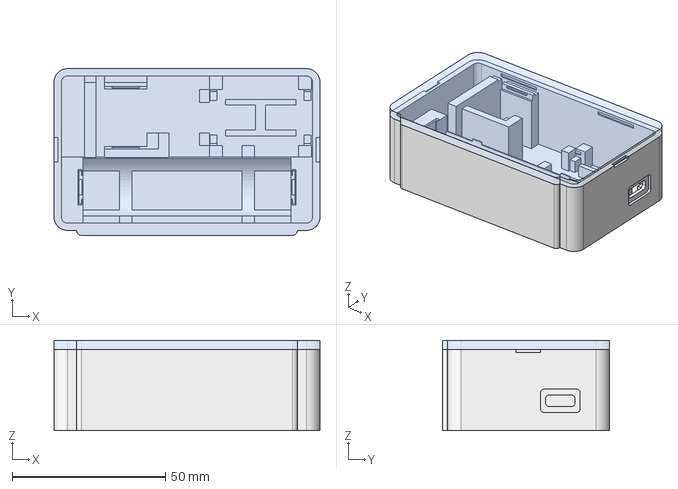
[picture p35: CAD file, 2026-11-10]
enclosure/out/vanity_assembly.step
86.8 x 54.4 x 29.4 mm
vanity_base
vanity_lid
