mcleancraig/presence-sensor-nrf/enclosure/out/aura_c_assembly.step

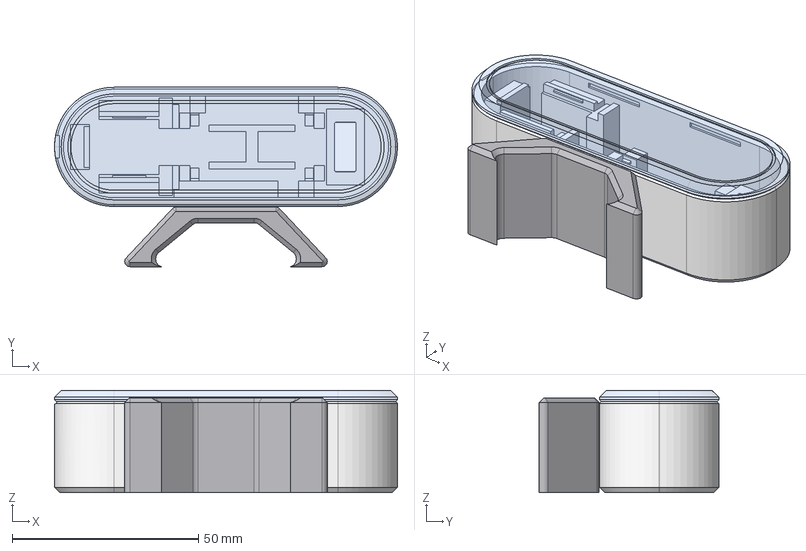
[picture p36: CAD file, 2026-11-10]
enclosure/out/aura_c_assembly.step
92.0 x 48.1 x 27.4 mm
aura_c_base
aura_c_lid
v_stand
