mcleancraig/presence-sensor-nrf/enclosure/out/assembly.step

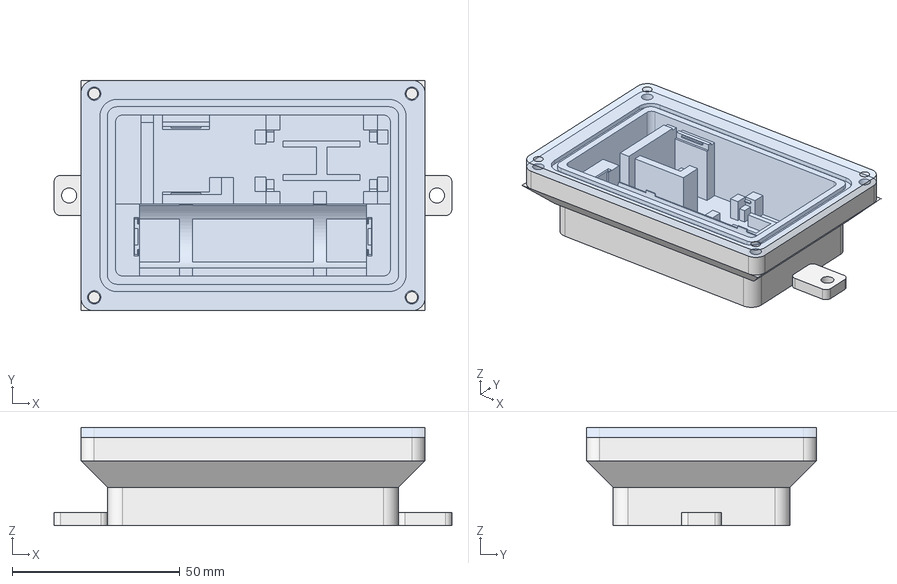
[picture p37: CAD file, 2026-11-10]
enclosure/out/assembly.step
118.8 x 68.8 x 29.4 mm
base
lid
