mcleancraig/presence-sensor-nrf/enclosure/out/vanity_base.step

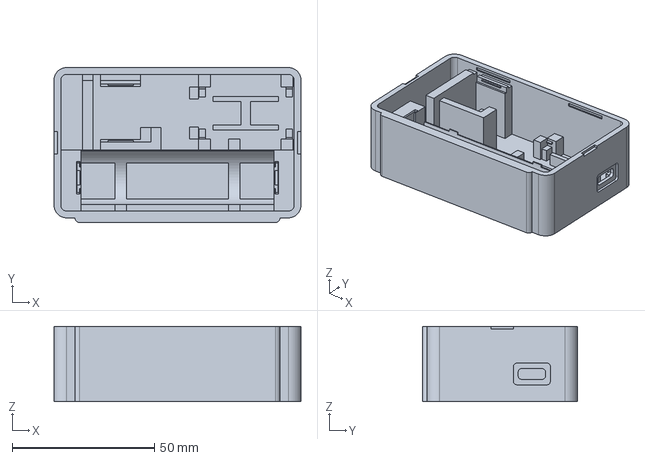
[picture p38: CAD file, 2026-11-10]
enclosure/out/vanity_base.step
86.8 x 54.4 x 26.4 mm
