mcleancraig/presence-sensor-nrf/enclosure/out/corner_bracket.step

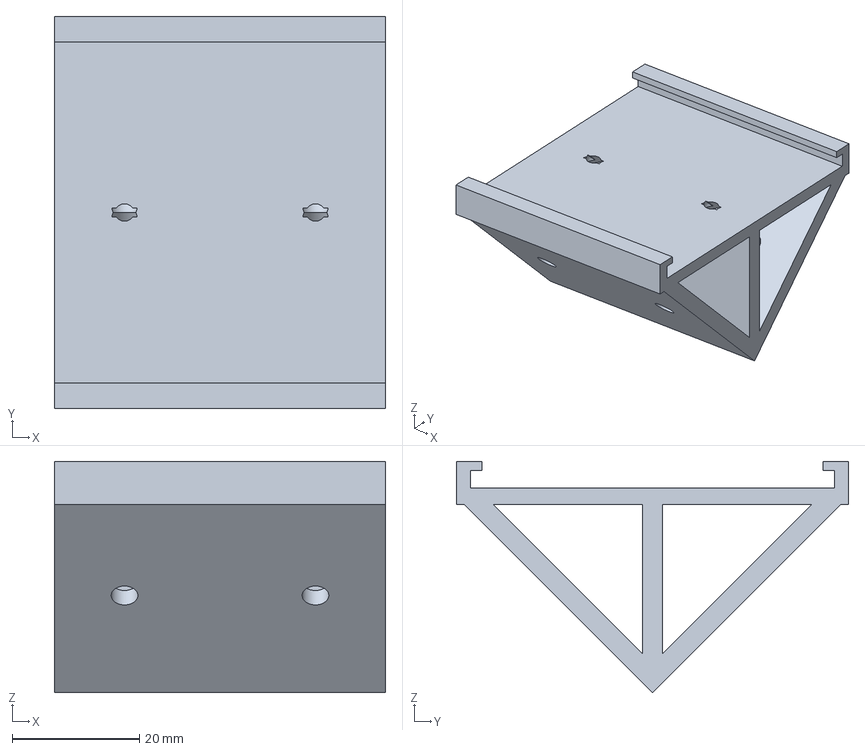
[picture p39: CAD file, 2026-11-10]
enclosure/out/corner_bracket.step
52.0 x 61.6 x 36.3 mm
