mcleancraig/presence-sensor-nrf/enclosure/out/lid.step

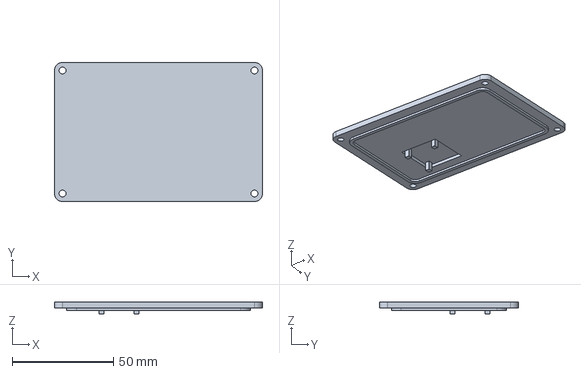
[picture p40: CAD file, 2026-11-10]
enclosure/out/lid.step
102.8 x 68.8 x 6.00 mm
