mcleancraig/presence-sensor-nrf/enclosure/out/aura_v2_stand.step

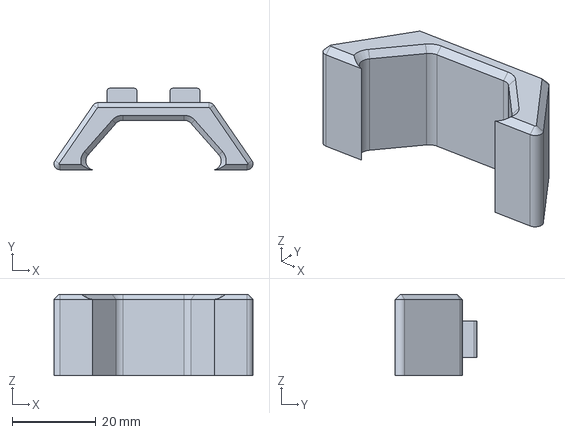
[picture p41: CAD file, 2026-11-10]
enclosure/out/aura_v2_stand.step
47.5 x 19.4 x 19.4 mm
