mcleancraig/presence-sensor-nrf/enclosure/out/ld2410s_usb_base.step

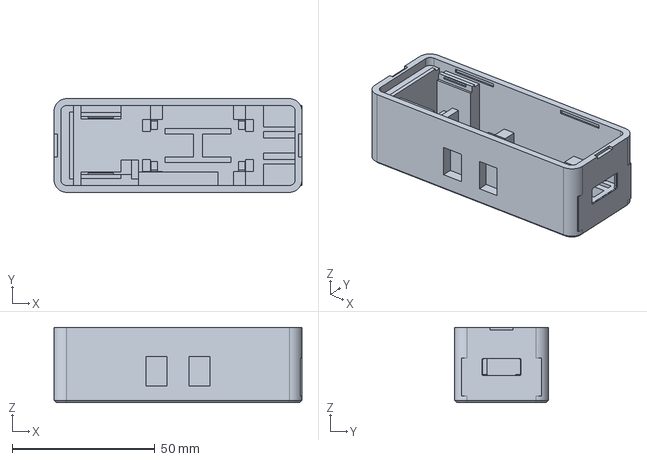
[picture p42: CAD file, 2026-11-10]
enclosure/out/ld2410s_usb_base.step
86.8 x 32.8 x 26.4 mm
