mcleancraig/presence-sensor-nrf/enclosure/out/aura_s_v2_lid.step

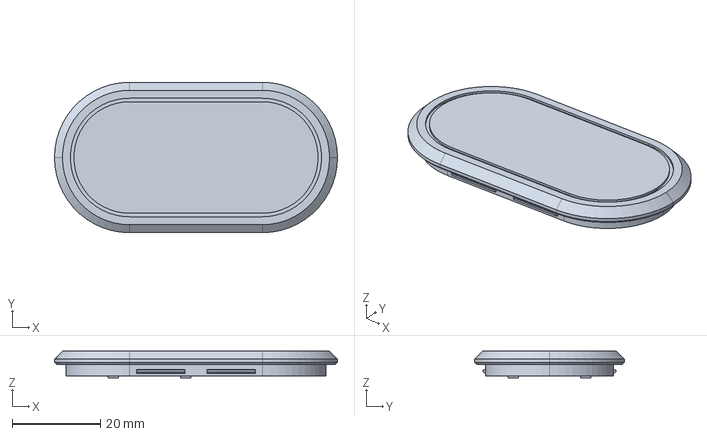
[picture p43: CAD file, 2026-11-10]
enclosure/out/aura_s_v2_lid.step
64.0 x 34.0 x 6.00 mm
