mcleancraig/presence-sensor-nrf/enclosure/out/aura_v2_base.step

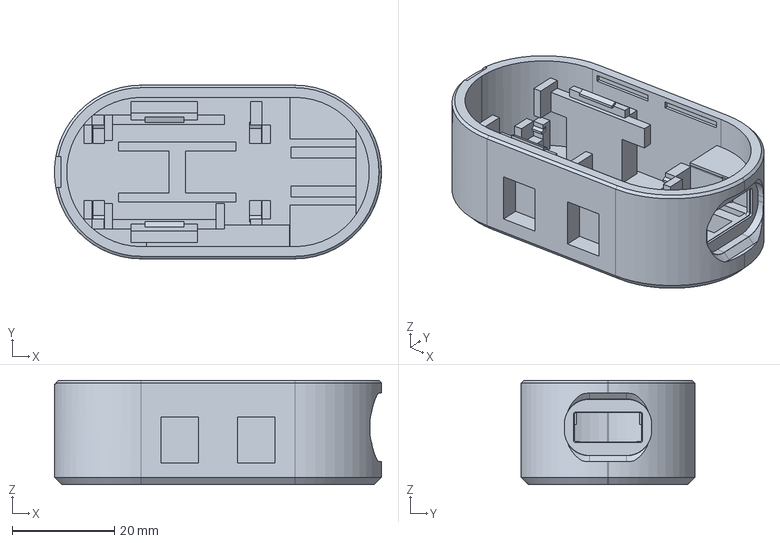
[picture p44: CAD file, 2026-11-10]
enclosure/out/aura_v2_base.step
64.0 x 34.0 x 20.4 mm
