mcleancraig/presence-sensor-nrf/enclosure/out/aura_s_lid.step

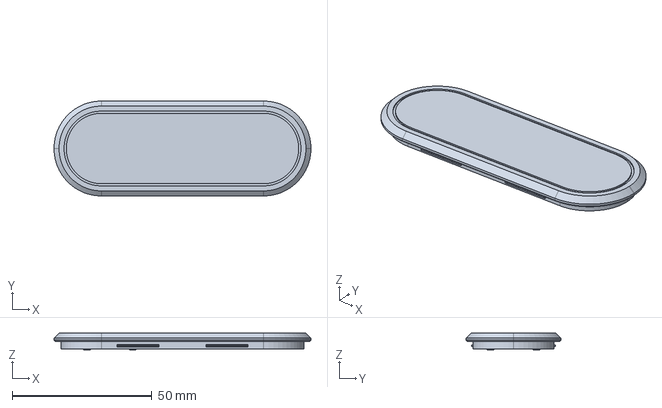
[picture p45: CAD file, 2026-11-10]
enclosure/out/aura_s_lid.step
92.0 x 34.0 x 6.00 mm
