mcleancraig/presence-sensor-nrf/enclosure/out/ld2410c_fit_check.step

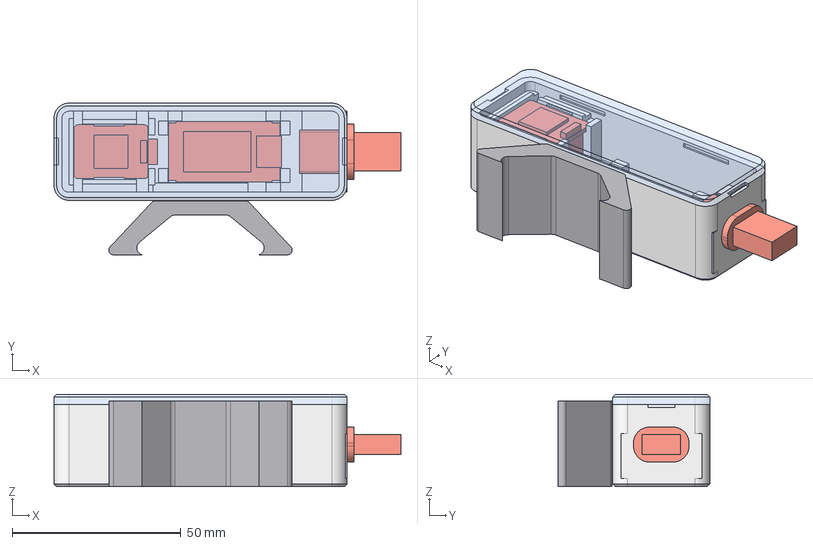
[picture p46: CAD file, 2026-11-10]
enclosure/out/ld2410c_fit_check.step
102.8 x 45.0 x 27.4 mm
ld2410c_base
ld2410c_lid
v_stand
board
board_parts
radar
radar_parts
dupont_5p
usb_c_socket
usb_c_plug
