mcleancraig/presence-sensor-nrf/enclosure/out/aura_s_v2_fit_check.step

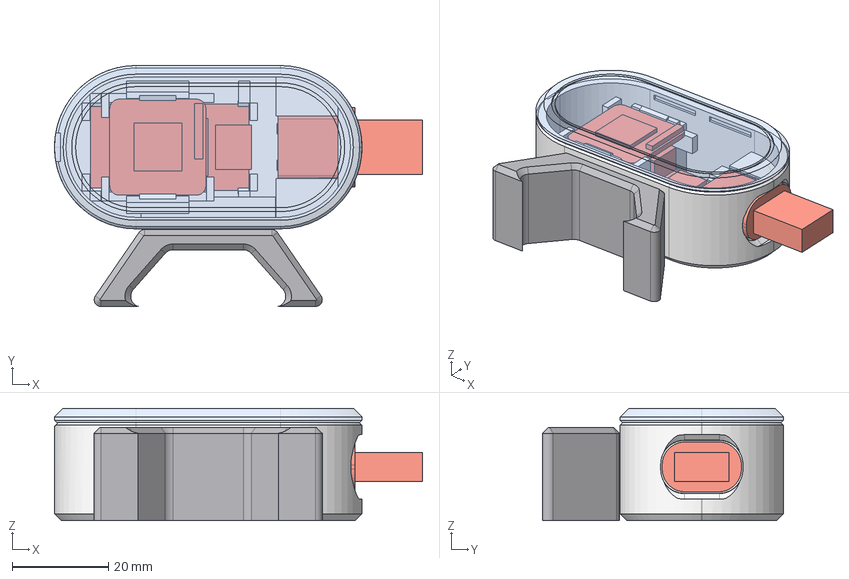
[picture p47: CAD file, 2026-11-10]
enclosure/out/aura_s_v2_fit_check.step
76.6 x 50.1 x 23.4 mm
aura_s_v2_base
aura_s_v2_lid
v_stand
board
board_parts
radar
radar_parts
direct_wires
usb_c_socket
usb_c_plug
