mcleancraig/presence-sensor-nrf/enclosure/out/fit_check.step

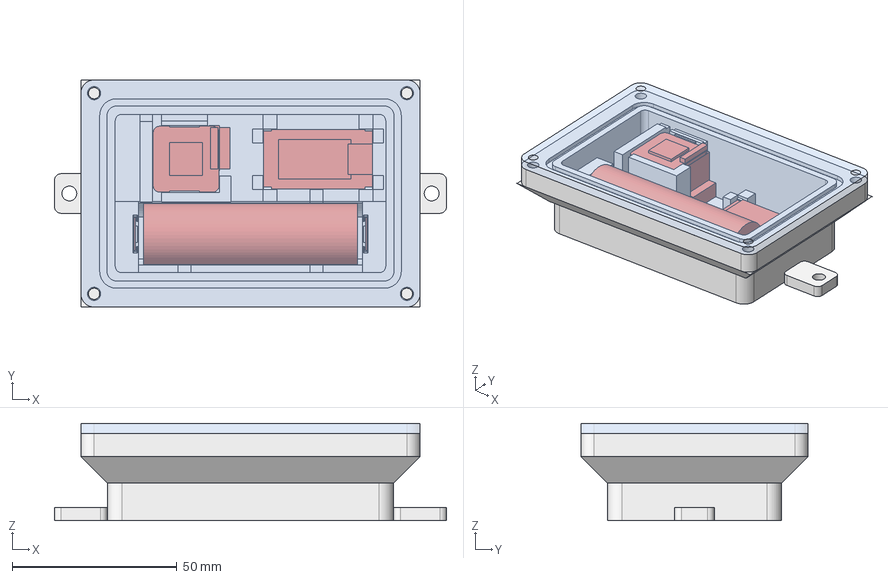
[picture p48: CAD file, 2026-11-10]
enclosure/out/fit_check.step
118.8 x 68.8 x 29.4 mm
base
lid
cell
plate_neg
plate_pos
board
board_parts
radar
radar_parts
dupont_5p
