mcleancraig/presence-sensor-nrf/enclosure/out/aura_c_v2_lid.step

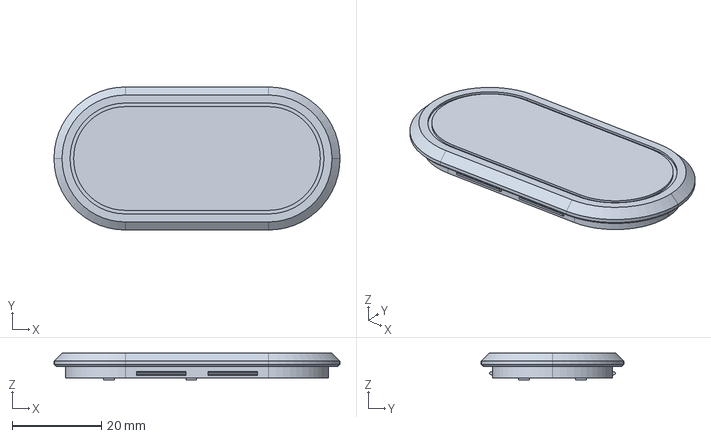
[picture p49: CAD file, 2026-11-10]
enclosure/out/aura_c_v2_lid.step
64.0 x 32.0 x 6.00 mm
