mcleancraig/presence-sensor-nrf/enclosure/out/ld2410s_usb_lid.step

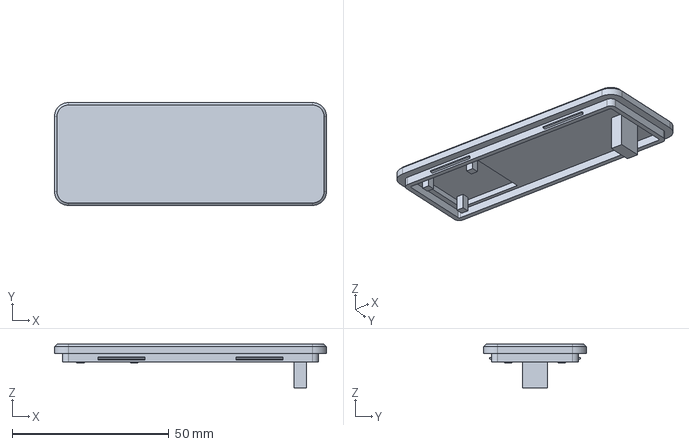
[picture p50: CAD file, 2026-11-10]
enclosure/out/ld2410s_usb_lid.step
86.8 x 32.8 x 13.9 mm
