mcleancraig/presence-sensor-nrf/enclosure/out/aura_c_lid.step

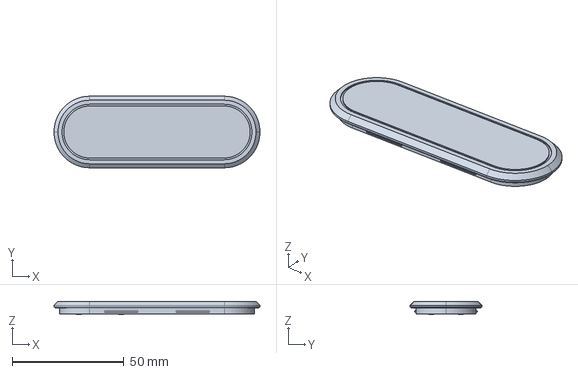
[picture p51: CAD file, 2026-11-10]
enclosure/out/aura_c_lid.step
92.0 x 32.0 x 6.00 mm
