mcleancraig/presence-sensor-nrf/enclosure/out/aura_c_fit_check.step

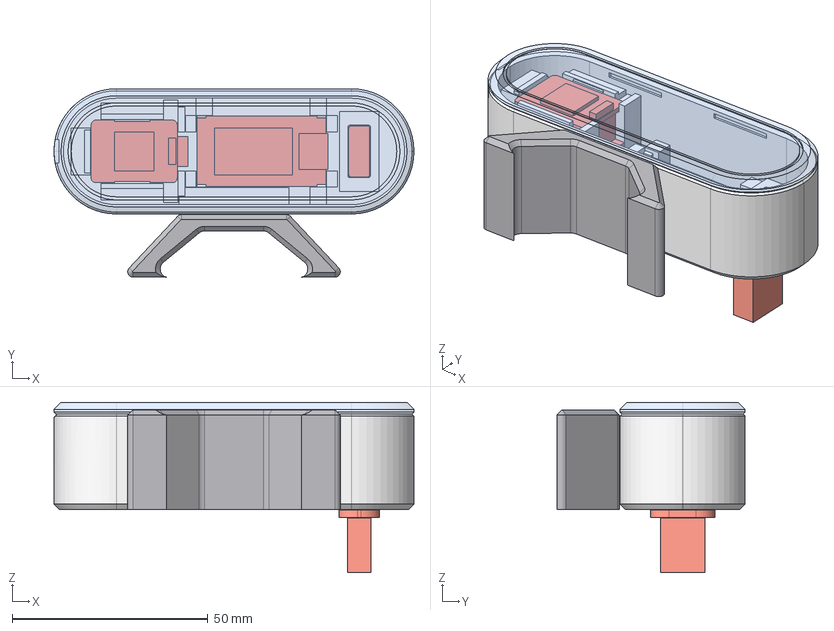
[picture p52: CAD file, 2026-11-10]
enclosure/out/aura_c_fit_check.step
92.0 x 48.1 x 43.5 mm
aura_c_base
aura_c_lid
v_stand
board
board_parts
radar
radar_parts
dupont_5p
usb_c_socket
usb_c_plug
