mcleancraig/presence-sensor-nrf/enclosure/out/vanity_lid.step

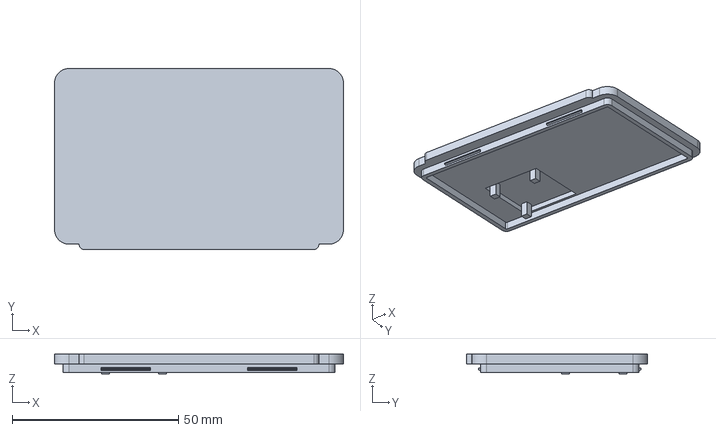
[picture p53: CAD file, 2026-11-10]
enclosure/out/vanity_lid.step
86.8 x 54.4 x 6.00 mm
