mcleancraig/presence-sensor-nrf/enclosure/out/ld2410s_usb_fit_check.step

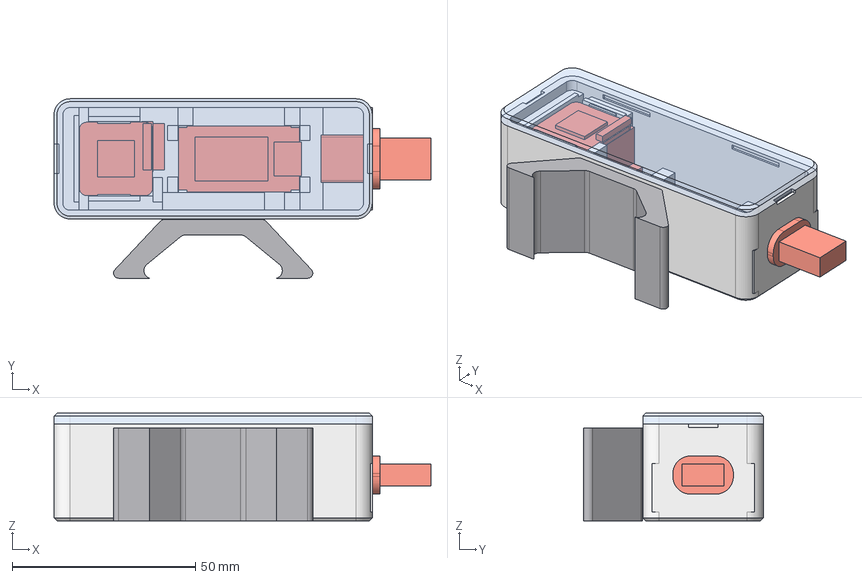
[picture p55: CAD file, 2026-11-10]
enclosure/out/ld2410s_usb_fit_check.step
102.8 x 48.9 x 29.4 mm
ld2410s_usb_base
ld2410s_usb_lid
v_stand
board
board_parts
radar
radar_parts
dupont_5p
usb_c_socket
usb_c_plug
