mcleancraig/presence-sensor-nrf/enclosure/out/aura_c_base.step

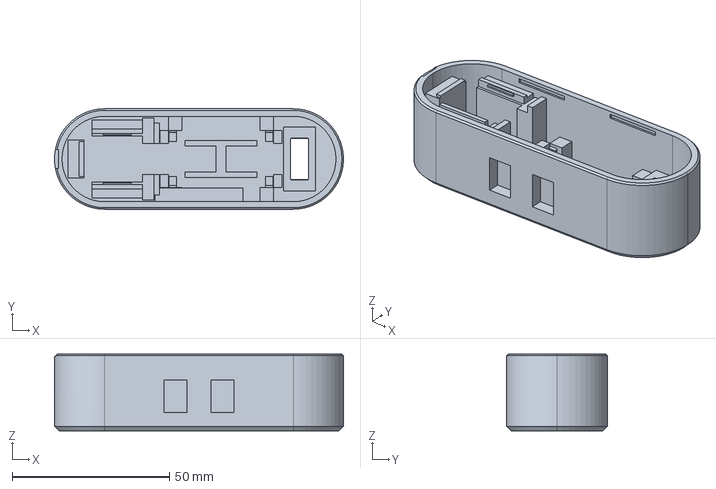
[picture p56: CAD file, 2026-11-10]
enclosure/out/aura_c_base.step
92.0 x 32.0 x 24.4 mm
