mcleancraig/presence-sensor-nrf/enclosure/out/aura_c_v2_base.step

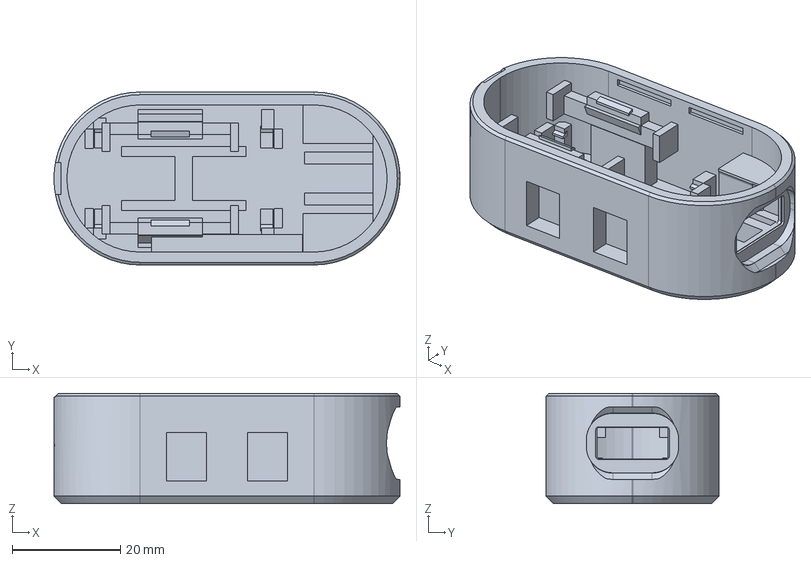
[picture p57: CAD file, 2026-11-10]
enclosure/out/aura_c_v2_base.step
64.0 x 32.0 x 20.4 mm
