mcleancraig/presence-sensor-nrf/enclosure/out/corner_fit_check.step

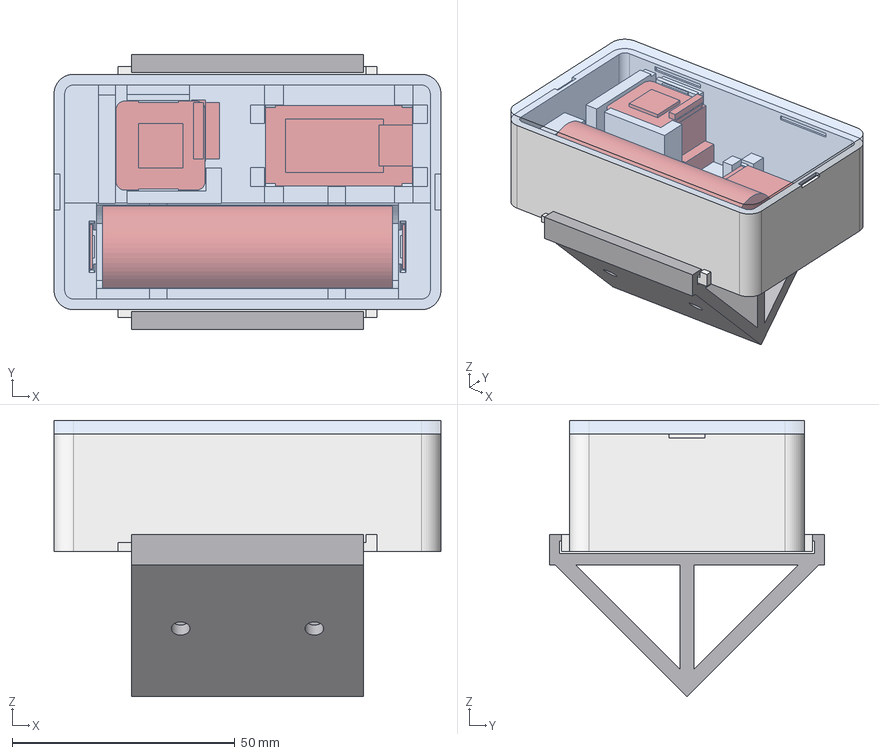
[picture p58: CAD file, 2026-11-10]
enclosure/out/corner_fit_check.step
86.8 x 61.6 x 61.9 mm
corner_base
corner_lid
corner_bracket
cell
plate_neg
plate_pos
board
board_parts
radar
radar_parts
dupont_5p
