mcleancraig/presence-sensor-nrf/enclosure/out/corner_lid.step

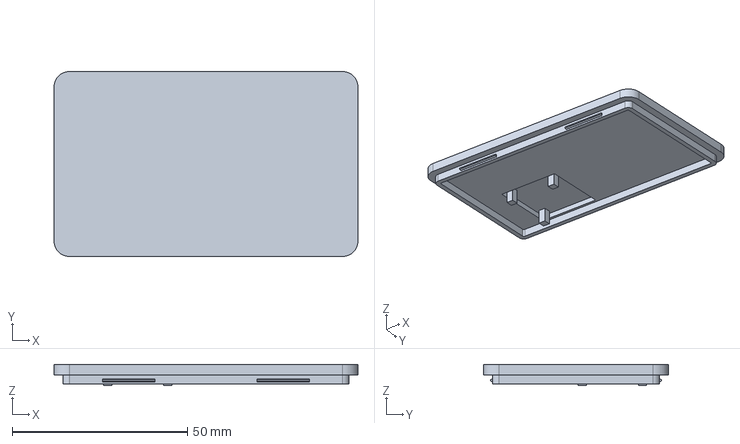
[picture p59: CAD file, 2026-11-10]
enclosure/out/corner_lid.step
86.8 x 52.8 x 6.00 mm
