mcleancraig/presence-sensor-nrf/enclosure/out/ld2410c_base.step

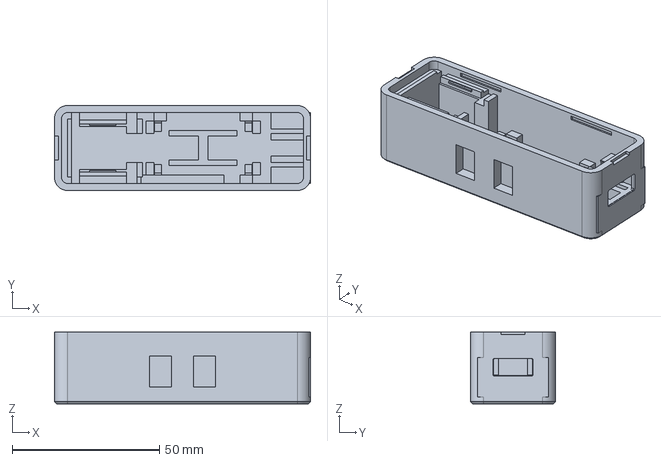
[picture p60: CAD file, 2026-11-10]
enclosure/out/ld2410c_base.step
86.8 x 28.8 x 24.4 mm
