mcleancraig/presence-sensor-nrf/enclosure/out/vanity_fit_check.step

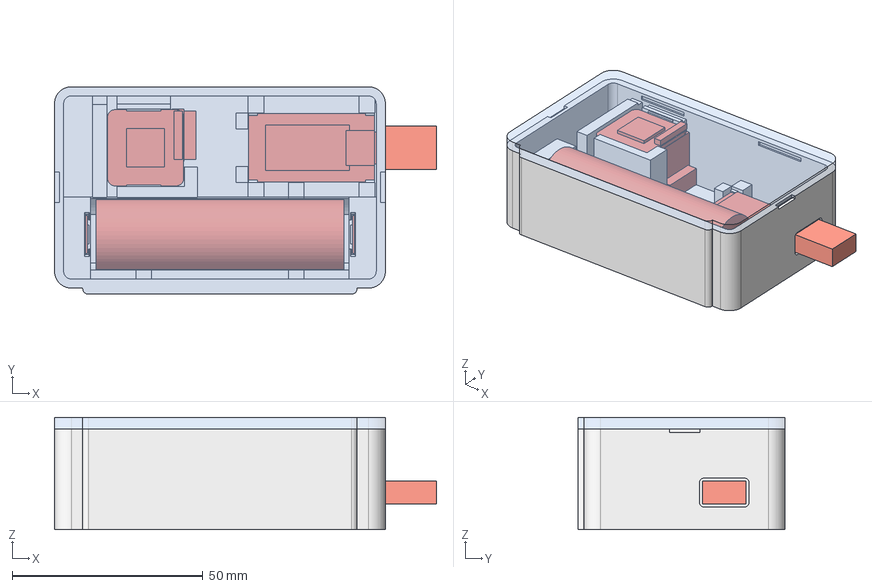
[picture p61: CAD file, 2026-11-10]
enclosure/out/vanity_fit_check.step
100.2 x 54.4 x 29.4 mm
vanity_base
vanity_lid
cell
plate_neg
plate_pos
board
board_parts
radar
radar_parts
dupont_5p
usb_c_plug
