mcleancraig/presence-sensor-nrf/enclosure/out/aura_c_stand.step

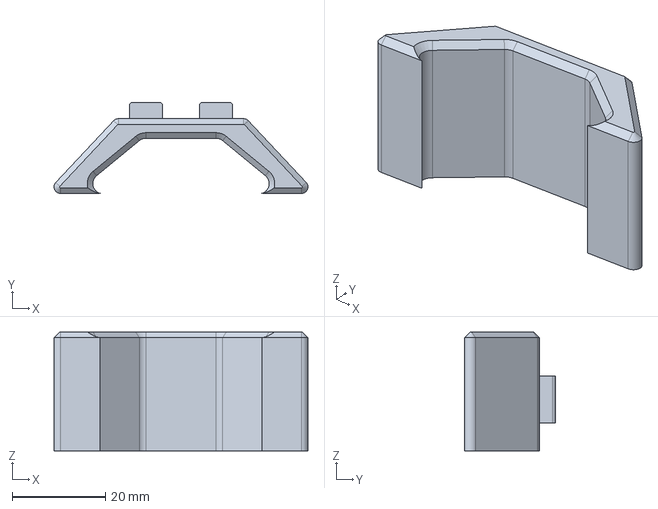
[picture p62: CAD file, 2026-11-10]
enclosure/out/aura_c_stand.step
54.3 x 19.4 x 25.4 mm
