mcleancraig/presence-sensor-nrf/enclosure/out/aura_c_v2_fit_check.step

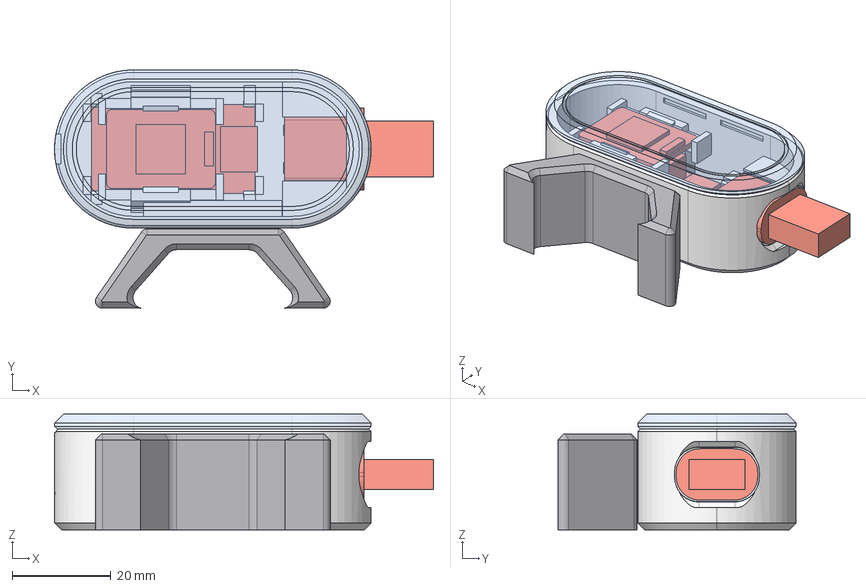
[picture p63: CAD file, 2026-11-10]
enclosure/out/aura_c_v2_fit_check.step
76.6 x 48.1 x 23.4 mm
aura_c_v2_base
aura_c_v2_lid
v_stand
board
board_parts
radar
radar_parts
direct_wires
usb_c_socket
usb_c_plug
