mcleancraig/presence-sensor-nrf/enclosure/out/corner_base.step

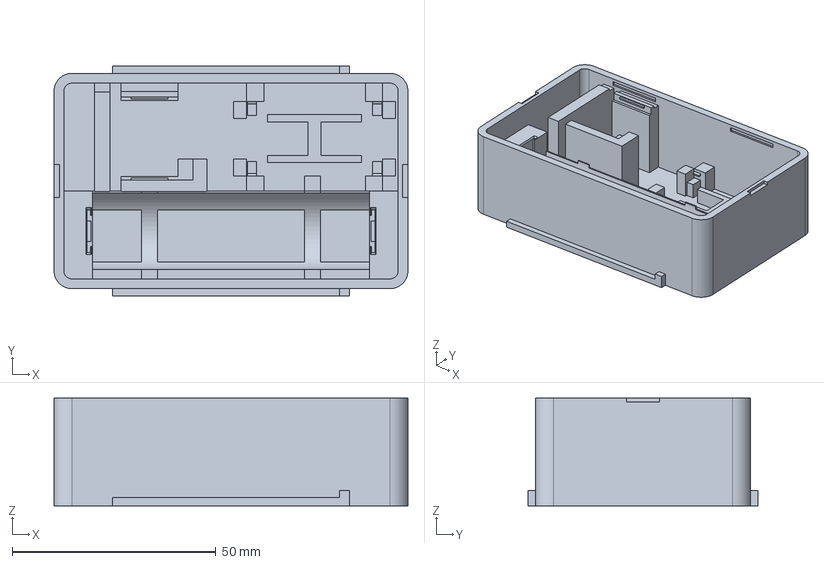
[picture p64: CAD file, 2026-11-10]
enclosure/out/corner_base.step
86.8 x 56.4 x 26.4 mm
