mcleancraig/presence-sensor-nrf/enclosure/out/aura_s_base.step

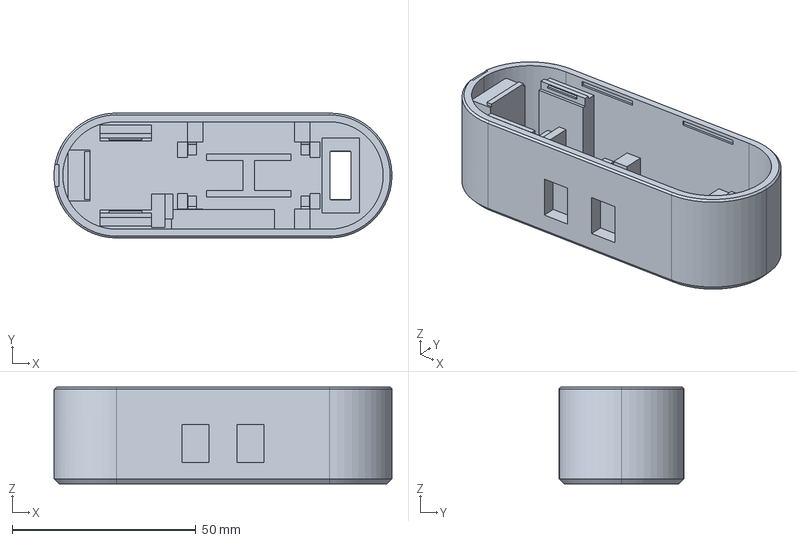
[picture p65: CAD file, 2026-11-10]
enclosure/out/aura_s_base.step
92.0 x 34.0 x 26.4 mm
