mcleancraig/presence-sensor-nrf/enclosure/out/ld2410c_lid.step

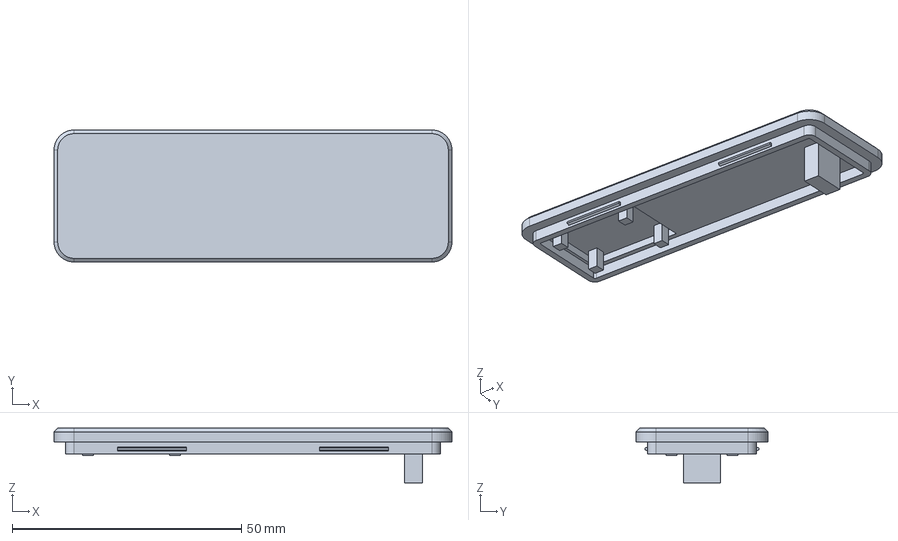
[picture p66: CAD file, 2026-11-10]
enclosure/out/ld2410c_lid.step
86.8 x 28.8 x 11.9 mm
