mcleancraig/presence-sensor-nrf/enclosure/out/aura_s_fit_check.step

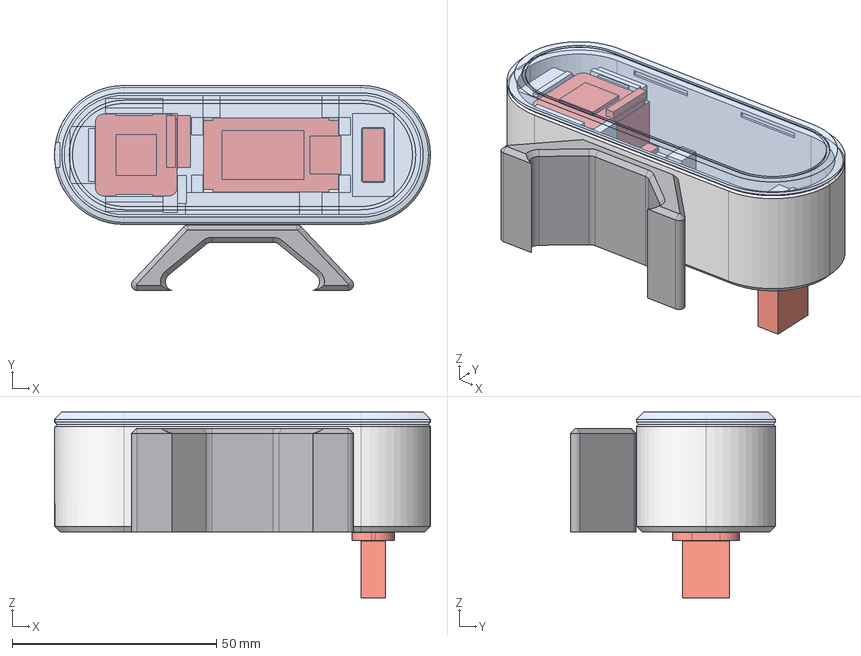
[picture p67: CAD file, 2026-11-10]
enclosure/out/aura_s_fit_check.step
92.0 x 50.1 x 45.5 mm
aura_s_base
aura_s_lid
v_stand
board
board_parts
radar
radar_parts
dupont_5p
usb_c_socket
usb_c_plug
