mcleancraig/presence-sensor-nrf/enclosure/out/base.step

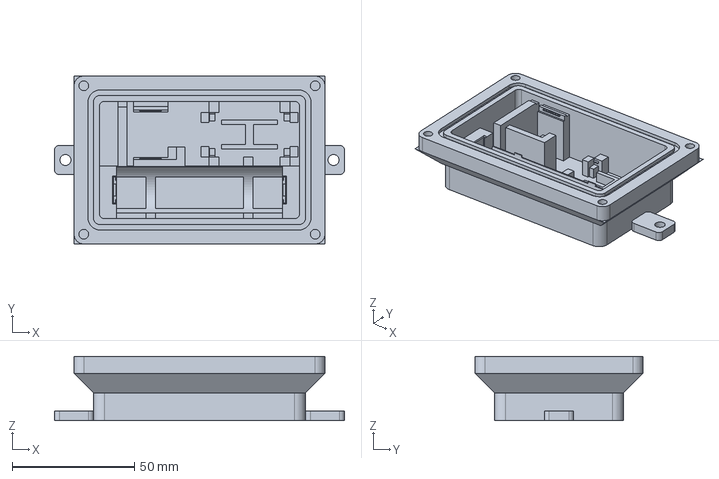
[picture p68: CAD file, 2026-11-10]
enclosure/out/base.step
118.8 x 68.8 x 26.4 mm
