mcleancraig/presence-sensor-nrf/enclosure/out/usbc_socket_fit_test.step

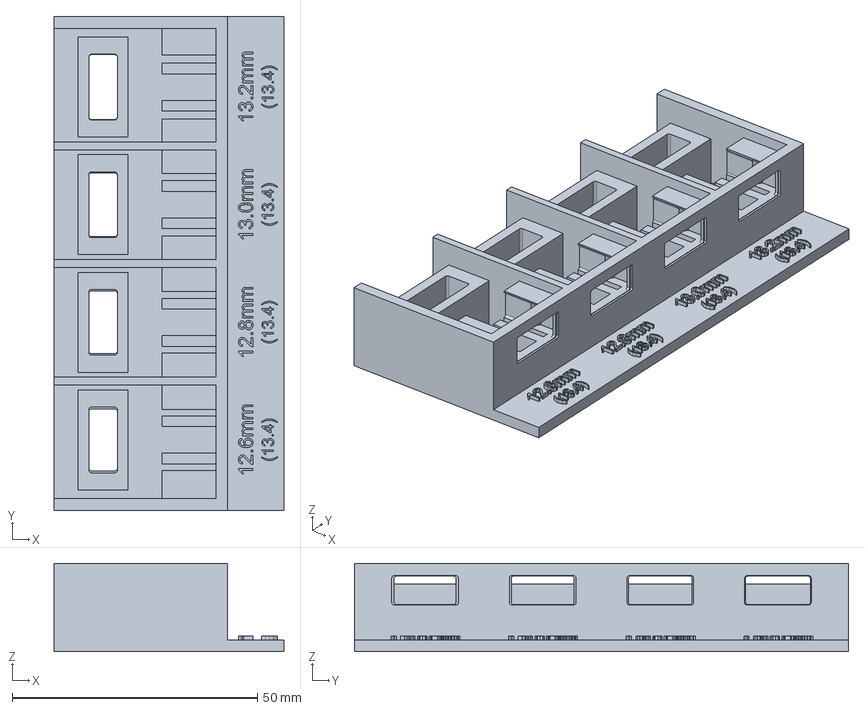
[picture p69: CAD file, 2026-11-10]
enclosure/out/usbc_socket_fit_test.step
46.9 x 100.8 x 18.0 mm
