mcleancraig/presence-sensor-nrf/(list of files, cad)

Other CAD files:
enclosure/out/aura_v2_assembly.step
enclosure/out/aura_v2_lid.step
enclosure/out/aura_c_v2_stand.step
enclosure/out/aura_s_v2_base.step
enclosure/out/aura_s_v2_stand.step
enclosure/out/aura_s_stand.step
enclosure/out/aura_v2_fit_check.step
enclosure/out/aura_c_base.stl
enclosure/out/aura_c_lid.stl
enclosure/out/aura_c_stand.stl
enclosure/out/aura_c_v1_assembly.step
enclosure/out/aura_c_v1_base.step
enclosure/out/aura_c_v1_base.stl
enclosure/out/aura_c_v1_fit_check.step
enclosure/out/aura_c_v1_lid.step
enclosure/out/aura_c_v1_lid.stl
enclosure/out/aura_c_v1_stand.step
enclosure/out/aura_c_v1_stand.stl
enclosure/out/aura_c_v2_base.stl
enclosure/out/aura_c_v2_lid.stl
enclosure/out/aura_c_v2_stand.stl
enclosure/out/aura_s_base.stl
enclosure/out/aura_s_lid.stl
enclosure/out/aura_s_stand.stl
enclosure/out/aura_s_v1_assembly.step
enclosure/out/aura_s_v1_base.step
enclosure/out/aura_s_v1_base.stl
enclosure/out/aura_s_v1_fit_check.step
enclosure/out/aura_s_v1_lid.step
enclosure/out/aura_s_v1_lid.stl
enclosure/out/aura_s_v1_stand.step
enclosure/out/aura_s_v1_stand.stl
enclosure/out/aura_s_v2_base.stl
enclosure/out/aura_s_v2_lid.stl
enclosure/out/aura_s_v2_stand.stl
enclosure/out/aura_v1_assembly.step
enclosure/out/aura_v1_base.step
enclosure/out/aura_v1_base.stl
enclosure/out/aura_v1_fit_check.step
enclosure/out/aura_v1_lid.step
enclosure/out/aura_v1_lid.stl
enclosure/out/aura_v1_stand.step
enclosure/out/aura_v1_stand.stl
enclosure/out/aura_v2_base.stl
enclosure/out/aura_v2_lid.stl
enclosure/out/aura_v2_stand.stl
enclosure/out/base.stl
enclosure/out/corner_base.stl
enclosure/out/corner_bracket.stl
enclosure/out/corner_lid.stl
enclosure/out/fit_check.stl
enclosure/out/ld2410c_base.stl
enclosure/out/ld2410c_lid.stl
enclosure/out/ld2410s_usb_base.stl
enclosure/out/ld2410s_usb_lid.stl
enclosure/out/lid.stl
enclosure/out/usbc_socket_fit_test.stl
enclosure/out/v_stand.stl
enclosure/out/vanity_base.stl
enclosure/out/vanity_lid.stl
