mcleancraig/presence-sensor-nrf/doc/bringup-notes.md

# Bring-up Notes: SuperMini nRF52840 + HLK-LD2410S BTHome v2 Sensor

This document records the hardware, bootloader, power-management, and protocol details required to run the Hi-Link HLK-LD2410S 24 GHz mmWave radar with BTHome v2 BLE on SuperMini nRF52840 (`nice!nano v2` clone) boards. Read it before modifying the flash layout, `uart0` power management, radar configuration commands, or battery sensing.

---

## 1. SuperMini nRF52840 Bootloader & Flash Layout (`0x1000`)

### Why `code_partition` starts at `0x1000` (not `0x26000`)
- The SuperMini nRF52840 ships with the Adafruit nRF52 UF2 bootloader (`Board-ID: nRF52840-nicenano`).
- When no Nordic S140 SoftDevice is installed (`SoftDevice: not found` in `/Volumes/NICENANO/INFO_UF2.TXT`), the Adafruit bootloader jumps directly to `MBR_SIZE` = **`0x1000`**, not `0x26000`.
- Upstream Zephyr `nice_nano` / `promicro_nrf52840/uf2` board definitions link the application at `0x26000` assuming S140 v6 is present. On a `nosd` board, an image linked at `0x26000` never boots (the bootloader jumps into erased flash at `0x1000` and falls back to DFU mode with a pulsing red LED).
- Because Zephyr's Bluetooth stack (`CONFIG_BT_LL_SOFTDEVICE=y`) links its own BLE controller inside the application binary, our `0x1000` UF2 image overwrites any pre-installed S140 SoftDevice on first flash; the bootloader then detects no SoftDevice and boots `0x1000` cleanly.
- **New boards with Bootloader `0.6.0`**: Check `/Volumes/NICENANO/INFO_UF2.TXT`. If it reports `0.6.0`, flash `update-nice_nano_bootloader-0.6.1_nosd.uf2` first, let the board reboot, double-click `RST` again, and then copy `build/zephyr/zephyr.uf2` using `cp -X`.

### macOS UF2 Copy Quirk
- Always flash from Terminal using `cp -X build/zephyr/zephyr.uf2 /Volumes/NICENANO/`.
- Because the bootloader reboots immediately upon receiving the final UF2 block, macOS reports `fcopyfile failed: Input/output error` (or a Finder disconnect alert) as the volume unmounts. This is expected behavior.

---

## 2. HLK-LD2410S Power & UART Sleep Architecture

### Why `P0.13` (`VCC`) Starts LOW and Enables After BLE Advertises (`USB-Only Benchtop Safety`)
- The HLK-LD2410S is **not** a one-shot sensor that can be cold-booted in a few milliseconds:
  1. Its onboard MCU and 24 GHz FMCW transceiver require `~1–2 s` after power-up to initialize and load their adaptive room noise floor.
  2. In **Low-Speed Mode** (`1 Hz` status/distance reporting), the HLK-LD2410S autonomously duty-cycles its own 24 GHz RF front-end down to **`58 – 100 µA` average current**.
  3. The HLK-LD2410S `VCC` pin requires **`3.0 V – 3.6 V`**. Connecting it directly to a raw Li-ion cell (`4.2 V` fully charged) exceeds its `3.6 V` rating.
- Therefore, the HLK-LD2410S `VCC` pin is wired to the SuperMini's **switched `VCC` header pin** (regulated `3.3 V` output controlled by `P0.13`, `power-cutoff-gpios`).
- **Critical USB-Only (`No Battery on B+`) Power Path (`TP4054` Charger Saga)**:
  - On the SuperMini nRF52840, USB `5V` feeds the `TP4054`/`LTH7R` Li-ion charger IC, and the charger's `BAT` output pin feeds `B+`, `VDDH`, and the `3.3 V` LDO (`VCC`).
  - When powered over USB-C **without an 18650 battery on `B+`/`B-`**, turning `P0.13` HIGH pulls `~50–70 mA` during the HLK-LD2410S boot chirp, causing the `TP4054` to enter constant-current/charge-indication mode (**Blue LED solid ON**) and causing `B+` (`VDDH`) to sag below `3000 mV`.
  - If `BatteryMonitor::Init()` turns `P0.13` HIGH before `SampleBattery()` or does not check `NRF_POWER->USBREGSTATUS.VBUSDETECT`, `ReadBatteryStatus()` sees `VDDH <= 3000 mV` and immediately executes `EnterSystemOff()` (`sys_poweroff()`), shutting down the MCU before `mRadar.Init()` or `mAdvertiser.Init()` is ever reached!
  - Therefore:
    1. `BatteryMonitor::Init()` initializes `P0.13` **LOW (`GPIO_OUTPUT_INACTIVE`)** so unloaded `VDDH` is sampled first.
    2. `BatteryMonitor::IsUsbVbusConnected()` checks `nrf_power_usbregstatus_vbusdet_get(NRF_POWER)` and **never** enters the 2-second cutoff confirmation loop or `sys_poweroff()` when USB VBUS is present.
    3. `AppTask::Start()` initializes `BthomeAdvertiser` and broadcasts the initial BTHome v2 packet **before** calling `BatteryMonitor::Instance().SetSensorPower(true)` (`P0.13` HIGH) and `mRadar.Init()`.

### Why `uart0` (`UARTE0`) Uses Explicit `PM_DEVICE=y` (`CONFIG_PM_DEVICE_RUNTIME=n`)
- An active nRF52840 `UARTE0` receiver keeps the 64 MHz HFCLK and EasyDMA bus active, drawing **`~500 – 1,000 µA`** continuously — up to 10× the current of the radar itself!
- Meanwhile, the HLK-LD2410S provides a dedicated digital presence output on **`OT2` (Pin 5)** (`HIGH` = occupied, `LOW` = unoccupied).
- Our architecture combines `OT2` GPIO interrupts on `P0.17` (`017` / `D2`) with explicit Zephyr Device Power Management (`CONFIG_PM_DEVICE=y`, `CONFIG_PM_DEVICE_RUNTIME=n`) on `uart0` (`P0.08` / `008` / `D0` RX, `P0.06` / `006` / `D1` TX):
  1. **Why `CONFIG_PM_DEVICE_RUNTIME=n` is mandatory alongside `CONFIG_UART_INTERRUPT_DRIVEN=y`**: In Zephyr's `uart_nrfx_uarte.c` (`uarte_nrfx_isr_int`), when both `CONFIG_PM_DEVICE_RUNTIME=y` and `CONFIG_UART_INTERRUPT_DRIVEN=y` are enabled, the ISR checks `NRF_UARTE_EVENT_TXSTOPPED` (which the driver initializes to `1` at boot) and calls `nrf_uarte_disable(uarte)` on the very first RX interrupt! That disables the hardware `UARTE0` peripheral mid-stream and causes `wait_tx_ready()` in `uart_poll_out()` to hang if RX arrives before TX. Using explicit `pm_device_action_run(mUartDev, PM_DEVICE_ACTION_RESUME / PM_DEVICE_ACTION_SUSPEND)` with `CONFIG_PM_DEVICE_RUNTIME=n` avoids this driver bug while preserving identical `< 15 µA` sleep current.
  2. **At boot**: `SensorLd2410s::Init()` enables `uart0` RX before the `1000 ms` (`kRadarBootSettleMs`) boot settle window so any boot frames emitted by the radar are captured in `mRxRing[256]`, sends the 3 m³ bathroom configuration command sequence (`0x00FF` -> `0x0070` (`8.0 Hz` report freq, `Fast` `10` response speed) -> `0x007A` Minimal 5-Byte output -> `0x00FE`), automatically probes swapped RX/TX pins (`RX=P0.06, TX=P0.08`) if zero bytes arrived on `RX=P0.08, TX=P0.06`, and immediately suspends `uart0` via `pm_device_action_run(mUartDev, PM_DEVICE_ACTION_SUSPEND)`.
  3. **Continuous Interrupt-Driven UART RX (`mRxRing[256]`) & Non-Blocking `SampleTargetReport()`**: Because the HLK-LD2410S transmits 5-byte (`0.43 ms` duration at `115200` baud) frames asynchronously on its internal timer (`8.0 Hz` or `1.0 Hz`), disabling `uart0` RX between polls would drop frames in hardware and cause `SampleTargetReport()` to time out and freeze `distanceMm` on a sticky `OT2` pin. Keeping `uart0` RX continuously armed in interrupt mode allows `OnUartIsr` to capture 100% of radar frames into `mRxRing[256]` with zero blind spots. `SampleTargetReport()` drains `mRxRing` non-blockingly (`< 1 ms`), clamps any target beyond `2100 mm` (`CONFIG_APP_RADAR_MAX_GATE * 700 mm`) to `Unoccupied`, and trusts valid UART `Unoccupied` / out-of-bounds reports over `OT2`.

### HLK-LD2410S Target State Encoding, `2100 mm` Bathroom Boundary & Kinematic Motion Synthesis (`Ld2410sMotionTracker`)
- In HLK-LD2410S report frames (`6E [state] [dist_lo] [dist_hi] 62` or `F4 F3 F2 F1 ... F8 F7 F6 F5`), the target state byte is encoded as:
  - `0x00` (`NoTarget`) / `0x01` (`Unoccupied`): `occupied = false`, `motion = false`, `distanceMm = 0`
  - `0x02` (`Stationary` / Minimal Occupied): `occupied = true`, `motion = false`
  - `0x03` (`Moving`): `occupied = true`, `motion = true`
- **Critical Hardware Quirks & Solutions (`Ld2410sMotionTracker` + `BthomeAdvertiser`)**:
  1. **Radial Kinematic Motion Tracking Across All Occupied States (`0x02` & `0x03`)**: In Minimal 5-Byte mode (`0x007A` = `0`), the HLK-LD2410S only emits `0x00`/`0x01` (Unoccupied) and `0x02` (Occupied). `Ld2410sMotionTracker` (`src/ld2410s_proto.h` / `src/ld2410s_proto.cpp`) evaluates radial distance kinematics (`|report.distanceMm - mLastMotionAnchorDistMm| >= 100 mm`) across **all** occupied frames (`0x02` and `0x03`) and never lets raw state bytes (`0x02` or `0x03`) bypass the `5000 ms` (`5.0 s`) stillness decay timer when `|delta| < 100 mm`.
  2. **Software `2100 mm` (`3 × 700 mm`) Bathroom Boundary Gate**: Even if a radar module's hardware `OT2` pin or internal gate configuration tracks reflections beyond `2.10 m` (e.g., `2.97 m` or `3.45 m` through a doorway), both `SensorLd2410s::SampleTargetReport()` and `Ld2410sMotionTracker::Update()` clamp any report with `distanceMm > 2100 mm` to `Unoccupied` (`occupied = false, motion = false, distanceMm = 0`) and never allow `OT2` to override a valid UART `Unoccupied` or out-of-bounds report.
  3. **ESPHome Wi-Fi/BLE Proxy Transition Reliability (`3.0 s` Burst + `15 s` Re-Assertion + `500 ms` Active Interval)**: To prevent shared-antenna ESPHome Wi-Fi/BLE proxies from missing a `motion -> off` or `occupancy -> off` packet during Wi-Fi transmit windows, `BthomeAdvertiser` bursts for `3000 ms` (`3.0 s` at `25–35 ms` interval = ~100 packets) on every state change, maintains a `~500 ms` advertising interval while occupied (`~1500 ms` when idle), and `AppTask` re-asserts state transitions every `3.2 s` for `15 s`.

### Sliding-Window Parser & Delimiter Collisions (`110 cm` / `98 cm`)
- In the HLK-LD2410S Minimal 5-Byte output format (`6E [state] [dist_lo] [dist_hi] 62`), the header byte is `0x6E` (`110` decimal) and the footer byte is `0x62` (`98` decimal).
- In a bathroom, a person standing at **`110 cm`** (`0x006E`) or **`98 cm`** (`0x0062`) produces distance payload bytes identical to the frame header or footer!
- A naive state machine that resets on any `0x6E` byte or terminates on any `0x62` byte will corrupt frames at `98 cm` and `110 cm`.
- `Ld2410sFrameParser` uses a fixed-offset sliding window in `mBuf` (`mBuf[0] == 0x6E && mBuf[4] == 0x62 && mBuf[1] <= 0x03`) and shifts by 1 byte (`DiscardPrefix(1)`) on mismatch so payload bytes containing `0x6E` or `0x62` never cause false frame synchronization.

---

## 3. Battery Sensing, HLK-LD2410S Mechanical Footprint & Hardware Notes

- **HLK-LD2410S Physical Footprint (`20.0 × 20.0 × 1.2 mm`) & `J2` Header (`2.54 mm` Pitch)**:
  - The Hi-Link HLK-LD2410S is a **`20.0 × 20.0 × 1.2 mm` square PCB** (`±10%` thickness tolerance) with **`R = 2.0 mm` rounded corners** and zero mounting screw holes.
  - Its 5-pin `J2` header (`Pin 1: 3V3`, `Pin 2: GND`, `Pin 3: OT1`, `Pin 4: RX`, `Pin 5: OT2`) uses a standard **`2.54 mm` (`0.100"`) pitch** (`10.16 mm` center-to-center span), with hole centers **`1.47 mm` inward from the `+X` PCB edge** and asymmetrically positioned from top (`+Y`) to bottom (`-Y`): `Pin 5 (OT2)` (**round pad right at the top corner**, `1.62 mm`), `Pin 4 (RX)` (`4.16 mm`), `Pin 3 (OT1)` (`6.70 mm`), `Pin 2 (GND)` (`9.24 mm`), and `Pin 1 (3V3)` (**square pad near the middle of the PCB edge**, `11.78 mm` from the top `+Y` edge / `8.22 mm` from the bottom `-Y` edge).
  - **Wiring Verification (`Pin 1` Square Pad vs. `Pin 5` Corner Round Pad)**: Because `Pin 5 (OT2)` sits at the corner (`1.62 mm`) while `Pin 1 (3V3)` sits near the middle of the PCB (`11.78 mm`), reversing the 5-pin header (`1..5` vs `5..1`) feeds `3.3 V` into `OT2` and swaps `GND` (`Pin 2`) with `RX` (`Pin 4`), causing the radar to back-power through ESD diodes, draw high current (lighting the SuperMini Blue charger LED), and fail to output UART frames. Always verify that `VCC` (`3.3 V`) connects to the **square pad (`Pin 1`) near the middle of the board**.
  - **SuperMini nRF52840 LEDs (Red `P0.15` Status LED vs. Blue `LTH7R`/`TP4054` Charger LED)**:
    - The software-controlled LED on `P0.15` (`led0`) is the **Red LED** (flashes `500 ms` once at boot and remains strictly OFF thereafter).
    - The **Blue LED** on SuperMini nRF52840 clones is hardwired to the `STAT` / `CHRG#` pin of the onboard `LTH7R` / `TP4054` Li-ion charger IC (not connected to any nRF52840 GPIO). When powered over USB-C **without a battery on `B+`/`B-`**, only a small `10 µF` decoupling capacitor sits on the `B+` (`BAT`) rail. Between UART/BLE bursts, the `TP4054` charges that `10 µF` capacitor to `4.2 V` and turns the Blue LED OFF. Whenever `uart0` wakes or a BLE burst transmits, the transient current draw discharges the `10 µF` capacitor below the `TP4054`'s `~4.1 V` recharge threshold, causing the `TP4054` to initiate a brief top-off charge cycle and flash the Blue LED. Once a real 18650 Li-ion battery is connected to `B+`/`B-` (and USB is unplugged), the `TP4054` is completely unpowered and the Blue LED never lights. Shortening the UART wake window to `~62 ms` (`8.0 Hz` radar reporting) also minimizes this capacitor voltage dip on USB power.
  - **Enclosure Orientation**:
    - **Antenna side (`TOP层`) faces UP (`+Z`)**: The two diagonally opposite 24 GHz patch antennas and the `ICL1112` transceiver IC face upward (`+Z`) into the lid's **`22 × 22 × 1.2 mm`** blind RF radome window.
    - **Component/header side (`Bottom层`) faces DOWN (`-Z`) with `J2` on `+X`**: The `PY32F030` MCU, `YXC` crystal, and `-Z` 5-pin `J2` header face downward (`-Z`) with **`19.5 mm`** of under-board vertical clearance, and the `J2` header edge faces **`+X` directly toward the SuperMini nRF52840** for short, unpinched wire routing.
  - **Optional `10–47 µF` Decoupling Capacitor**: Because `Pin 1 (3V3)` and `Pin 2 (GND)` on `J2` are immediately adjacent (`2.54 mm` pitch), an optional `10–47 µF` decoupling capacitor can be soldered directly across Pins 1 and 2 on the `-Z` underside to smooth 24 GHz chirp current spikes.
- **SAADC `VDDH/5`**: On the SuperMini nRF52840, the external voltage divider is misrouted to `P0.24` (a digital-only pin), so battery voltage is measured internally via `NRF_SAADC_VDDHDIV5` (`ADC_GAIN_1_2` = `1/2` gain, `0.6 V` internal reference = `1.2 V` full-scale = `6.0 V` at `VDDH`, 12-bit resolution, 16× hardware oversampling).
- **USB Power Reading**: While USB-C is plugged in, `VDDH` reads `~4.8 V` (`100 %`). True cell voltage is measured only when running from the battery on `B+`/`B-`.
- **No Reverse-Polarity Protection**: The SuperMini `B+`/`B-` pads have no reverse-polarity protection diode. Always verify battery polarity with a multimeter before inserting into the enclosure contacts.
- **Why Both `RAW` and `B+` Measure `~4.1 V` on USB-C Power (Powering the HLK-LD2410C)**:
  - Unlike an Arduino Pro Micro where `RAW` exposes USB `5 V` (`VBUS`), on the SuperMini nRF52840 schematic the top-right through-hole **`RAW`** pin and the front **`B+`** pad are **shorted together on the exact same PCB net (`VBAT` / `VDDH`)**.
  - USB-C `5.0 V` (`VBUS`) connects only to the nRF52840 internal `VBUS` pin and through the top-side Schottky diode **`D1`** into **`Pin 4` (`VCC` input)** of the 5-pin **`LTH7R` (`LP4057` / `TP4054` SOT-23-5)** Li-ion battery charger IC. The `LTH7R` charger's **`Pin 3` (`BAT` output)** drives both **`B+` and `RAW`**, regulating them to the Li-ion float/recharge voltage of **`~4.1 V – 4.2 V`** when no battery is attached.
  - Because `LTH7R` defaults to a **`100 mA` Constant-Current limit** (`Rprog = 10 kΩ`) and the HLK-LD2410C draws `~70–80 mA` continuous with `120–200 mA` chirp peaks, connecting the HLK-LD2410C to an unmodified `RAW`/`B+` pin triggers `LTH7R` current limiting (Blue LED ON and voltage sag). Use either:
    1. **`RAW` or `B+` (`~4.1 V`) + Underside `BI-PROG` Jumper Bridged (`300 mA`)**: Bridge the 2-pad **`BI-PROG`** (`Battery I-PROG`, next to `VDD / DIO / CLK / GND` on the underside of the `nice!nano` clone; labeled `BOOST` on genuine `nice!nano v2`) solder jumper to raise the `LTH7R` current limit from `100 mA` to **`300 mA`**. Because the HLK-LD2410C steps `VCC` down to `3.3 V` via an onboard `SOT-23-5` `3.3 V` LDO (`~0.25 V` dropout), a stiff `4.1 V` (`300 mA`) rail on `RAW`/`B+` provides `~0.8 V` of LDO headroom.
    2. **True `~4.7–5.0 V` USB `VBUS` Tap at `D1` / `LTH7R Pin 4`**: Solder the HLK-LD2410C `VCC` wire to the cathode/anode of the **`D1` Schottky diode** (or **`LTH7R Pin 4`** / its adjacent input capacitor pad) right behind the USB-C socket on the top of the SuperMini PCB to bypass the `LTH7R` charger IC completely.

---

## 4. BTHome v2 & Home Assistant Discovery

- **Ascending Object IDs (`0x23` Occupancy vs `0x2D` Window)**: BTHome v2 parsers require Object IDs inside the `0xFCD2` Service Data payload to appear in ascending numerical order: `0x00` (Packet ID), `0x01` (Battery %), `0x0C` (Voltage V), `0x21` (Motion), `0x23` (Occupancy: `Clear` / `Detected`), `0x40` (Distance mm). Do **not** use `0x2D` for occupancy — in the official BTHome v2 spec, `0x2D` is `window` (`Closed` / `Open`). If Home Assistant previously discovered the sensor with `0x2D`, delete the device in **Settings → Devices & Services → BTHome → `Presence-XXXX` → Delete** so Home Assistant re-discovers it with `0x23` (`Occupancy`).
- **Scannable Legacy Advertising (`<= 31 B`)**: Putting the Complete Local Name (`Presence-XXXX`, 13 bytes) inside the primary Advertising Data alongside Flags (3 B) and BTHome Service Data (19 B) would total 37 bytes and fail `bt_le_adv_start()` with `-EINVAL`. Keep Flags + Service Data (`22 B`) in the primary Advertising Data (`ad[]`) and place `BT_DATA_NAME_COMPLETE` (`15 B`) in the Scan Response (`sd[]`) with `BT_LE_ADV_OPT_SCANNABLE`.
- **Unique Identity per Board**: `BthomeAdvertiser::Init()` reads the hardware device ID via `hwinfo_get_device_id()`, derives a deterministic Static Random BLE MAC address, and formats the `Presence-XXXX` suffix using the folded 16-bit FNV-1a hash in `BthomeProto::DeriveShortIdFromDeviceId()`, ensuring multiple bathroom/room sensors never collide in Home Assistant.

---

## 5. Debugging Over USB CDC ACM

- Build with `-DEXTRA_CONF_FILE=debug.conf -DEXTRA_DTC_OVERLAY_FILE=debug.overlay` (or `scripts/fetch-firmware.sh --debug`).
- In the debug build, console logs are routed over **USB CDC ACM** (`/dev/cu.usbmodem*`) while hardware `uart0` remains dedicated to the HLK-LD2410S radar on `P0.08` (`008` / `D0` RX) and `P0.06` (`006` / `D1` TX).
- `main()` waits up to 10 seconds for a terminal (`screen /dev/cu.usbmodem* 115200`) to assert DTR before starting radar configuration so early boot logs are captured.
- `CONFIG_APP_DEBUG_KEEP_ALIVE=y` (`src/debug_fatal.c`) keeps USB CDC ACM alive if an assertion or fatal fault occurs on an application thread.
