mcleancraig/presence-sensor-nrf/enclosure/out/sections/usbc_socket_fit_test_z.png

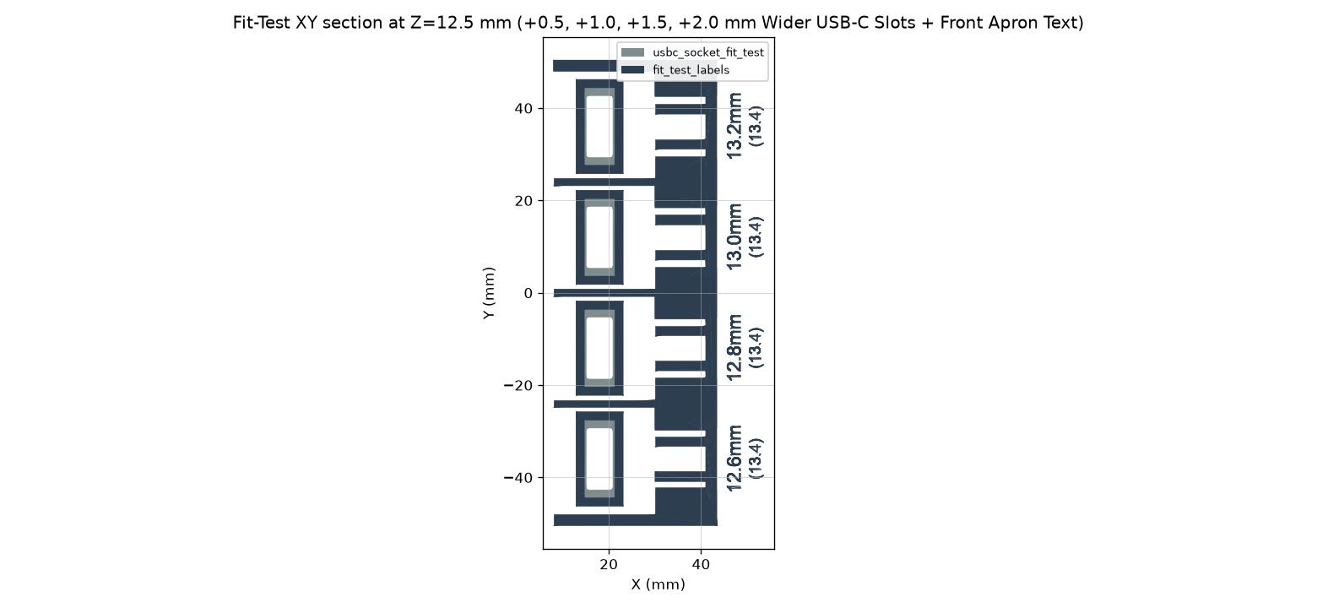
enclosure/out/sections/usbc_socket_fit_test_z.png
