mcleancraig/presence-sensor-nrf/src/app_task.cpp

/*
 * Copyright (c) 2026 Craig McLean
 * Application Task & Low-Power Event Loop (HLK-LD2410S + OpenThread SED + Home Assistant MQTT)
 */

#include "app_task.h"
#include "status_led.h"
#include "version.h"
#include <zephyr/logging/log.h>

LOG_MODULE_REGISTER(app_task, LOG_LEVEL_INF);

namespace {

static constexpr uint32_t kEvtOt2Edge                      = BIT(0);
static constexpr uint32_t kEvtOccupiedPoll                 = BIT(1);
static constexpr uint32_t kEvtHeartbeat                    = BIT(2);
static constexpr uint32_t kEvtBatterySample                = BIT(3);
static constexpr uint32_t kEvtBurstDone                    = BIT(4);
static constexpr uint16_t kDistanceBurstThresholdMm        = 150u;
static constexpr int64_t  kMinDistancePublishIntervalMs    = 1500;
static constexpr int64_t  kPostTransitionReassertWindowMs  = 15000;
static constexpr int64_t  kPostTransitionReassertPeriodMs  = 3200;

} // namespace

AppTask::AppTask()
    : mBatteryStatus{BatteryMonitor::VOLTAGE_NOMINAL_MV, 50, BatteryChargeLevel::OK, false},
      mLastRadarReport{Ld2410sTargetState::Unoccupied, false, false, 0, 0, true, false, 0, 0, 0, 0, 0, 0},
      mPendingEvents(ATOMIC_INIT(0)),
      mLastStateChangeMs(0),
      mLastPublishMs(0),
      mLastPublishedDistanceMm(0u),
      mLastOccupied(false),
      mLastMotion(false)
{
}

void AppTask::OnOt2EdgeStatic()
{
    Instance().NotifyOt2Edge();
}

void AppTask::OnHeartbeatTimer(struct k_timer *timer)
{
    ARG_UNUSED(timer);
    Instance().PostEvent(kEvtHeartbeat);
}

void AppTask::OnOccupiedPollTimer(struct k_timer *timer)
{
    ARG_UNUSED(timer);
    Instance().PostEvent(kEvtOccupiedPoll);
}

void AppTask::OnBatteryTimer(struct k_timer *timer)
{
    ARG_UNUSED(timer);
    Instance().PostEvent(kEvtBatterySample);
}

void AppTask::PostEvent(uint32_t eventMask)
{
    atomic_or(&mPendingEvents, static_cast<atomic_val_t>(eventMask));
    k_sem_give(&mEventSem);
}

void AppTask::NotifyOt2Edge()
{
    PostEvent(kEvtOt2Edge);
}

void AppTask::NotifyBurstComplete()
{
    PostEvent(kEvtBurstDone);
}

void AppTask::SampleBattery()
{
    BatteryStatus status{};
    if (BatteryMonitor::Instance().ReadBatteryStatus(&status) == 0) {
        mBatteryStatus = status;
    }
}

void AppTask::PublishCurrentState(bool burst)
{
    const BthomeMeasurement m = {
        .packetId   = 0, // Auto-incremented inside ThreadMqttPublisher::Publish
        .batteryPct = mBatteryStatus.percentRemaining,
        .voltageMv  = mBatteryStatus.voltageMv,
        .motion     = mLastRadarReport.motion,
        .occupancy  = mLastRadarReport.occupied,
        .distanceMm = mLastRadarReport.distanceMm,
    };

    mLastPublishMs = k_uptime_get();
    (void)mPublisher.Publish(m, burst);
}

void AppTask::HandleOt2AndDistanceUpdate(bool forceBurst, bool forcePublish)
{
    Ld2410sReport report{};
    mRadar.SampleTargetReport(&report);

    const int64_t nowMs = k_uptime_get();
    static constexpr uint16_t kMaxDistanceMm =
        static_cast<uint16_t>(CONFIG_APP_RADAR_MAX_DISTANCE_MM);
    static constexpr int64_t kOccupancyHoldWindowMs =
        static_cast<int64_t>(CONFIG_APP_RADAR_HOLD_S) * 1000;
    mMotionTracker.Update(&report, nowMs, kMaxDistanceMm, kOccupancyHoldWindowMs);
    mLastRadarReport = report;

    const Ld2410sReport rawReport = mRadar.GetLastValidReport();
    mPublisher.UpdateRadarDiag({
        .rawState         = rawReport.rawState,
        .movingEnergy     = rawReport.movingEnergy,
        .stationaryEnergy = rawReport.stationaryEnergy,
        .movingDistCm     = rawReport.movingDistanceCm,
        .stationaryDistCm = rawReport.stationaryDistanceCm,
        .detectionDistCm  = rawReport.detectionDistanceCm,
        .rxBytes          = mRadar.GetRxBytesSeen(),
        .configured       = mRadar.IsRadarConfigured(),
        .occupied         = report.occupied,
        .motion           = report.motion,
    });

    const bool stateChanged = (report.occupied != mLastOccupied) ||
                              (report.motion != mLastMotion);
    const bool occupancyEdge = (report.occupied != mLastOccupied);
    const uint16_t distDeltaMm = (report.distanceMm > mLastPublishedDistanceMm)
                                     ? (report.distanceMm - mLastPublishedDistanceMm)
                                     : (mLastPublishedDistanceMm - report.distanceMm);
    const bool significantDistChange =
        report.occupied &&
        (distDeltaMm >= kDistanceBurstThresholdMm) &&
        ((nowMs - mLastPublishMs) >= kMinDistancePublishIntervalMs);

    if (stateChanged) {
        mLastStateChangeMs = nowMs;
        mRadar.LogDiagnostics(report, forceBurst ? "ot2-edge" : "state-chg");
    } else if (forceBurst) {
        mRadar.LogDiagnostics(report, "ot2-edge");
    } else {
        static int64_t sLastDiagLogMs = 0;
        if ((nowMs - sLastDiagLogMs) >= 2000) {
            sLastDiagLogMs = nowMs;
            mRadar.LogDiagnostics(report, "diag-2s");
        }
    }

    // Re-assert recent occupancy/motion transitions every 3.2 s for 15 s on battery/SED builds;
    // skipped on always-USB-powered Thread MED builds where TCP/MQTT delivery is continuous.
    const bool shouldReassertTransition =
        !IS_ENABLED(CONFIG_APP_ALWAYS_USB_POWERED) &&
        (mLastStateChangeMs > 0) &&
        ((nowMs - mLastStateChangeMs) <= kPostTransitionReassertWindowMs) &&
        ((nowMs - mLastPublishMs) >= kPostTransitionReassertPeriodMs);

    mLastOccupied = report.occupied;
    mLastMotion   = report.motion;

    const bool shouldBurst = forceBurst ||
                             occupancyEdge ||
                             stateChanged ||
                             significantDistChange ||
                             shouldReassertTransition;
    if (shouldBurst || forcePublish) {
        mLastPublishedDistanceMm = report.distanceMm;
        PublishCurrentState(shouldBurst);
    }
}

int AppTask::Start()
{
    LOG_INF("Starting OpenThread SED + Home Assistant MQTT mmWave Presence Sensor v%s (build %d)",
            APP_VERSION_STRING, APP_BUILD_NUMBER);

    k_sem_init(&mEventSem, 0, K_SEM_MAX_LIMIT);
    k_timer_init(&mHeartbeatTimer, OnHeartbeatTimer, nullptr);
    k_timer_init(&mOccupiedPollTimer, OnOccupiedPollTimer, nullptr);
    k_timer_init(&mBatteryTimer, OnBatteryTimer, nullptr);

    // 1. Initialize Battery Monitor with P0.13 LOW (radar unpowered) and configure SAADC VDDH/5
    int ret = BatteryMonitor::Instance().Init();
    if (ret != 0) {
        LOG_ERR("BatteryMonitor::Init failed (err: %d)", ret);
        StatusLed::Instance().BlinkError(2);
    }

    // Read initial unloaded battery/VBUS voltage before enabling the radar 3.3 V rail
    SampleBattery();

    // 2. Initialize OpenThread Sleepy End Device (SED) + Home Assistant MQTT Publisher
    ret = mPublisher.Init();
    if (ret != 0) {
        LOG_ERR("ThreadMqttPublisher::Init failed (err: %d)", ret);
        StatusLed::Instance().BlinkError(4);
        return ret;
    }
    PublishCurrentState(true);

    // 3. Enable P0.13 3.3 V VCC rail and initialize HLK-LD2410S (P0.17 OT2 + uart0 config + auto pin-swap probe)
    (void)BatteryMonitor::Instance().SetSensorPower(true);
    ret = mRadar.Init(OnOt2EdgeStatic);
    if (ret != 0) {
        LOG_ERR("SensorLd2410s::Init failed (err: %d)", ret);
        StatusLed::Instance().BlinkError(3);
    }

    // Ensure P0.15 status LED is strictly OFF before entering the low-power event loop
    StatusLed::Instance().Set(false);

    // 4. Perform initial radar sample and queue/publish updated state
    HandleOt2AndDistanceUpdate(true, true);

    // 5. Start periodic low-power timers (400 ms sub-second radar UART poll + heartbeat + battery)
    k_timer_start(&mOccupiedPollTimer,
                   K_MSEC(CONFIG_APP_RADAR_POLL_INTERVAL_MS),
                   K_MSEC(CONFIG_APP_RADAR_POLL_INTERVAL_MS));
    k_timer_start(&mHeartbeatTimer,
                   K_SECONDS(CONFIG_APP_HEARTBEAT_INTERVAL_SEC),
                   K_SECONDS(CONFIG_APP_HEARTBEAT_INTERVAL_SEC));
    k_timer_start(&mBatteryTimer,
                   K_SECONDS(CONFIG_APP_BATTERY_SAMPLE_INTERVAL_SEC),
                   K_SECONDS(CONFIG_APP_BATTERY_SAMPLE_INTERVAL_SEC));

    LOG_INF("Entering System ON low-power event loop (poll=%dms, heartbeat=%ds, battery=%ds)",
            CONFIG_APP_RADAR_POLL_INTERVAL_MS,
            CONFIG_APP_HEARTBEAT_INTERVAL_SEC,
            CONFIG_APP_BATTERY_SAMPLE_INTERVAL_SEC);

    while (true) {
        k_sem_take(&mEventSem, K_FOREVER);

        const uint32_t events = static_cast<uint32_t>(atomic_clear(&mPendingEvents));

        if (events & kEvtBatterySample) {
            SampleBattery();
        }

        const bool forceBurst   = (events & kEvtOt2Edge) != 0u;
        const bool forcePublish = (events & kEvtHeartbeat) != 0u;

        if (events & (kEvtOt2Edge | kEvtOccupiedPoll)) {
            HandleOt2AndDistanceUpdate(forceBurst, forcePublish);
        } else if (forcePublish) {
            PublishCurrentState(false);
        }

        // Flush any queued boot/reconnect publish once Thread attaches and service MQTT keepalive
        mPublisher.ProcessBackground();
    }

    return 0;
}
