mcleancraig/presence-sensor-nrf/(commit log)

2026-10-28 Initial commit: HLK-LD2410S + SuperMini nRF52840 bathroom presence sensor (BTHome v2 + CadQuery enclosure)
    [assembly.step, base.step, base.stl, fit_check.step, lid.step, lid.stl]
2026-10-29 Redesign enclosure for exact HLK-LD2410S (20x20x1.2mm) footprint and 2.54mm J2 pin/cable clearance
    [assembly.step, base.step, base.stl, fit_check.step, fit_check.stl, lid.step, lid.stl]
2026-10-29 Add 45-deg corner snap-fit and USB-C vanity pod enclosure models for HLK-LD2410S
    [assembly.step, base.step, corner_assembly.step, corner_base.step, corner_base.stl, corner_bracket.step, corner_bracket.stl, corner_fit_check.step]
2026-10-29 fix(firmware): fix BTHome 0x23 occupancy ID, interrupt UART0 RX, and LD2410S boot/frame handling (v1.0.1)
    [app_task.cpp, app_task.h, bthome_proto.cpp, bthome_proto.h, ld2410s_proto.cpp, ld2410s_proto.h, sensor_ld2410s.cpp, sensor_ld2410s.h]
2026-10-30 fix(firmware): guard USB VBUS against false System OFF, start BLE before radar power-up, disable UART runtime PM, and auto-probe RX/TX pin swap (v1.0.2)
    - Bypass battery under-voltage System OFF cutoff when USB VBUS is connected (BatteryMonitor::IsUsbVbusConnected()) so USB-only benchtop testing with the HLK-LD2410S load on VCC (TP4054 B+ rail) never shuts down the MCU.
    - Initialize BLE BTHome v2 advertising (0x23 Occupancy) in AppTask::Start() before enabling P0.13 (VCC) and mRadar.Init().
    - Set CONFIG_PM_DEVICE_RUNTIME=n in prj.conf so Zephyr's uart_nrfx_uarte.c ISR does not disable UARTE0 on TXSTOPPED.
    - Align app.overlay default uart0 pins (UART_RX = P0.08, UART_TX = P0.06) with the sold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
    [app_task.cpp, battery_monitor.cpp, battery_monitor.h, sensor_ld2410s.cpp, sensor_ld2410s.h, version.h]
2026-10-30 fix(firmware): fix HLK-LD2410S 0x02/0x03 target state mapping and sub-second bathroom trigger latency (v1.0.3)
    - Map HLK-LD2410S target states accurately: 0x00=NoTarget, 0x01=Unoccupied (clamp stale distance to 0), 0x02=Stationary (occupied=true, motion=false), 0x03=Moving (occupied=true, motion=true).
    - Configure HLK-LD2410S at 8.0 Hz (125 ms frame period) and Fast response speed (10) with 220 ms UART sample window (1150 ms fallback if unconfigured).
    - Add < 5 ms immediate BLE burst on rising OT2 edge before UART distance read, 400 ms periodic UART poll interval (CONFIG_APP_RADAR_POLL_INTERVAL_MS), and 25-35 ms BLE burst cadence for 1000 ms.
    - Expand host protocol unit test suite to 94 asse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
    [app_task.cpp, bthome_advertiser.h, ld2410s_proto.cpp, ld2410s_proto.h, sensor_ld2410s.cpp, sensor_ld2410s.h, test_protocols.cpp, version.h]
2026-10-30 fix(firmware): synthesize active motion from radial distance kinematics in HLK-LD2410S minimal mode (v1.0.4)
    [app_task.cpp, app_task.h, bthome_advertiser.h, ld2410s_proto.cpp, ld2410s_proto.h, sensor_ld2410s.h, test_protocols.cpp, version.h]
2026-10-30 fix(firmware): keep UART0 RX continuous, clamp 2.1m bathroom boundary, and re-assert BTHome transitions (v1.0.5)
    [app_task.cpp, app_task.h, bthome_advertiser.cpp, bthome_advertiser.h, ld2410s_proto.cpp, ld2410s_proto.h, sensor_ld2410s.cpp, sensor_ld2410s.h]
2026-10-30 feat(enclosure): join battery and radar cradles to walls, add nRF snap-hooks/hold-downs, and fit 10x10mm terminals & 5-pin DuPont
    [assembly.step, base.step, base.stl, corner_assembly.step, corner_base.step, corner_base.stl, corner_bracket.step, corner_fit_check.step]
2026-10-31 fix(enclosure): align lid embossed tongue rim with base debossed perimeter groove (v3.1)
    [assembly.step, fit_check.step, fit_check.stl, lid.step, lid.stl]
2026-11-02 Enable +8 dBm BLE TX power (v1.0.6)
2026-11-02 feat(thread-mqtt): migrate from BLE BTHome to OpenThread SED + NAT64 + Home Assistant MQTT (v1.1.0)
2026-11-02 fix(thread-mqtt): pace HA discovery over 6LoWPAN and expand TCP net_buf pools to prevent -ENOBUFS (v1.1.1)
    [app_task.cpp, main.cpp, thread_mqtt_publisher.cpp, thread_mqtt_publisher.h, version.h]
2026-11-06 feat(ld2410c): add HLK-LD2410C radar, enclosure & occupancy hold
    Add support for the 5 V constant-powered Hi-Link HLK-LD2410C (22x16 mm)
    mmWave sensor alongside the battery-powered HLK-LD2410S (v1.2.0):
    - Parse 23-byte Normal (0x02, 0xAA..0x55) and 45-byte Engineering (0x01)
    HLK-LD2410C frames at 256000/115200 baud with 0x0060/0x0064 gate and
    sensitivity configuration.
    - Add 30 s stationary occupancy hold expiration (CONFIG_APP_RADAR_HOLD_S)
    and gate-hop immunity in Ld2410sMotionTracker::Update so static near-
    field reflections (state 0x02) decay cleanly to Unoccupied without
    blocking genuine Moving (0x01/0x03) re-entry.
    - Add Model 4 compact battery-free USB-C enclosure (ld2410c_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
    [ld2410c_assembly.step, ld2410c_base.step, ld2410c_base.stl, ld2410c_fit_check.step, ld2410c_lid.step, ld2410c_lid.stl]
2026-11-06 feat(ota): add wireless MQTT FOTA, Thread MED & office LD2410C tuning
    - Refresh HLK-LD2410C motion/occupancy hold on any Doppler Moving (0x01/0x03) frame even when radial delta < 100 mm, and preserve Moving state across drained 10 Hz ring-buffer batches.
    - Configure 3.0 m office geometry (Gate 4, 2950 mm max distance, 180 s hold) and 100 ms (10 Hz) polling in ld2410c.conf.
    - Disable battery power-saving handicaps when CONFIG_APP_ALWAYS_USB_POWERED=y (Always-On OpenThread MED with RxOnWhenIdle=true, continuous uart0 RX, and mqtt_ping keepalive fix).
    - Add OtaUpdater (Slot 1 staging at 0x00076000, CRC-32 & Cortex-M4 vector validation, SRAM __ramfunc NVMC installer, remote GPREGRET=0x57 UF2 boo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
    [app_task.cpp, ld2410s_proto.cpp, ld2410s_proto.h, ota_updater.cpp, ota_updater.h, sensor_ld2410s.cpp, test_protocols.cpp]
2026-11-09 Add Aura v1 & compact stacked Aura v2 (S/C) enclosures, ld2410s_usb, V-stands, and calibrated 3-zone USB-C clip-retention bay
    [assembly.step, aura_c_assembly.step, aura_c_base.step, aura_c_base.stl, aura_c_fit_check.step, aura_c_lid.step, aura_c_lid.stl, aura_c_stand.step]
2026-11-09 fix(ld2410c): prevent overnight occupancy latching and harden MQTT/FOTA
    [app_task.cpp, ld2410s_proto.cpp, ld2410s_proto.h, ota_updater.cpp, ota_updater.h, sensor_ld2410s.cpp, sensor_ld2410s.h]
2026-11-10 enclosure: move Aura v2 USB-C port to sculpted flush-alcove +X side bay
    [assembly.step, aura_c_assembly.step, aura_c_base.step, aura_c_fit_check.step, aura_c_lid.step, aura_c_stand.step, aura_c_v1_assembly.step, aura_c_v1_base.step]
2026-11-10 docs: unify LD2410S/LD2410C battery & USB wiring table and update 9-model enclosure catalog
